kzexal/DATN/type c.webp

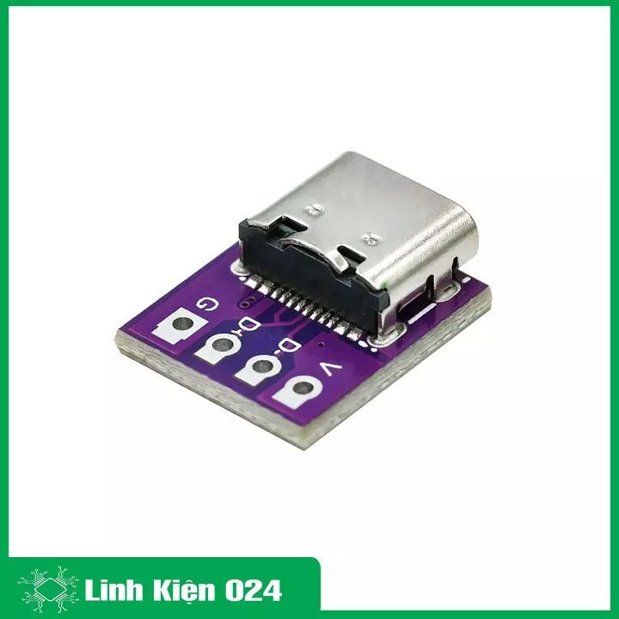
type c.webp
