kzexal/DATN/oled.webp

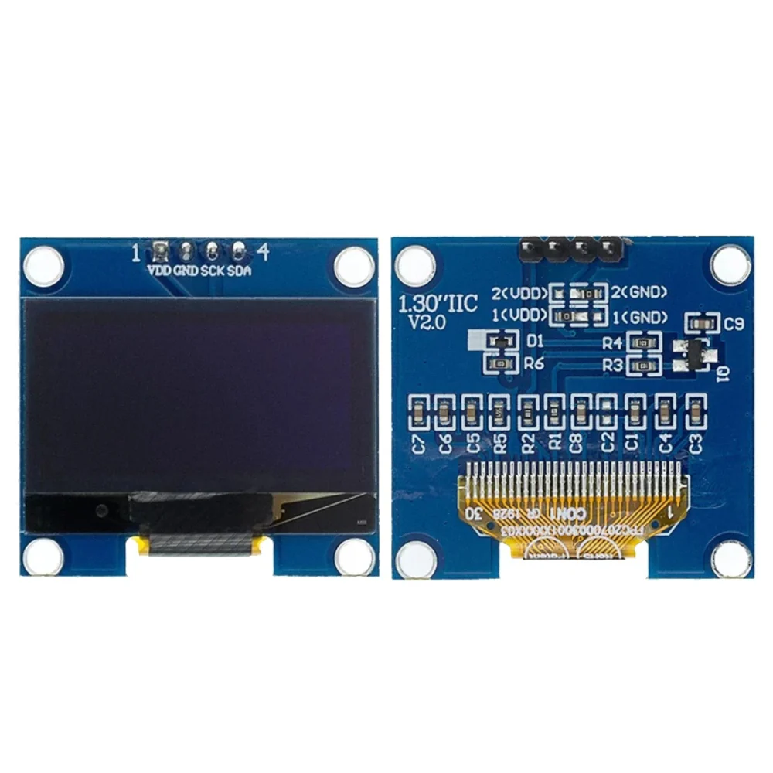
oled.webp
