kzexal/DATN/[SLIDE]_Đào Bá Khánh_ĐATN_Thiết kế, triển khai hệ thống IOT phát hiện và cảnh báo mất trộm, tai nạn xe máy.pptx.pdf

# ĐỒ ÁN TỐT NGHIỆP CỬ NHÂN

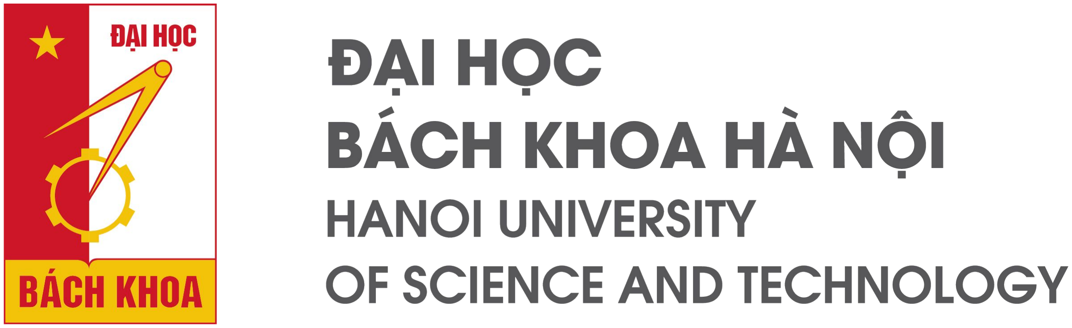
[picture p4: figure]

# THIẾT KẾ, TRIỂN KHAI HỆ THỐNG IOT

PHÁT HIỆN VÀ CẢNH BÁO MẤT TRỘM,

# TAI NẠN XE MÁY

## Đề tài:

Sinh viên: Đào Bá Khánh
MSSV: 20192932 - ET1 09 K64 GVHD: TS. Trịnh Quang Đức

# Demo

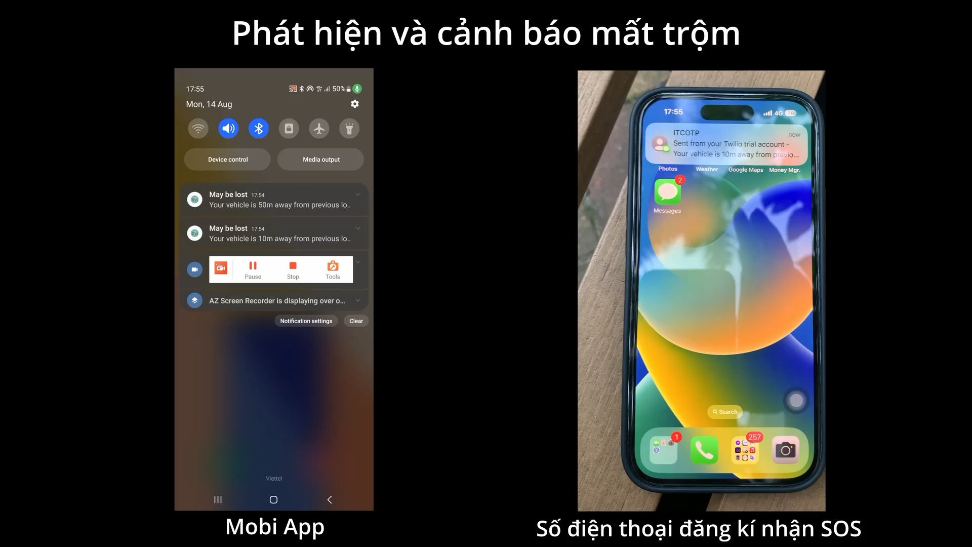
[picture p5: page 4]

## 1. TỔNG QUAN ĐỀ TÀI

5

# NỘI DUNG TRÌNH BÀY

### 1 TỔNG QUAN DỰ ÁN

KIỂM THỬ - ĐÁNH GIÁ

THIẾT KẾ - TRIỂN KHAI HỆ THỐNG

KẾT LUẬN - HƯỚNG PHÁT TRIỂN

2

3

4

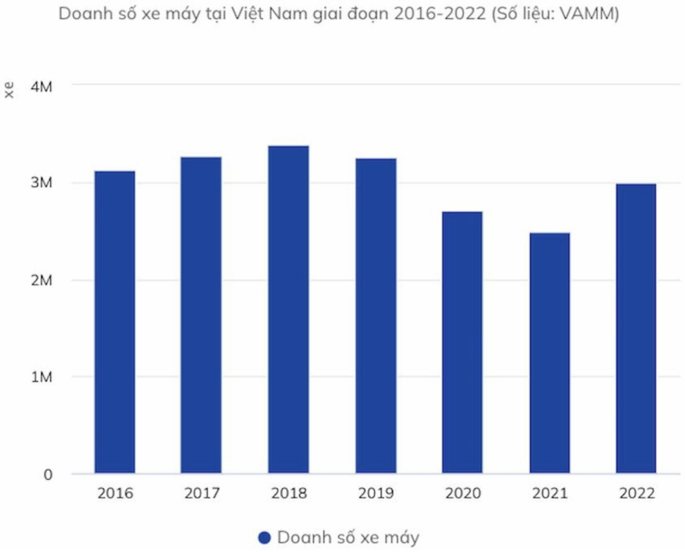
[picture p6: figure]

6

## 1 TỔNG QUAN DỰ ÁN

### 1.1 Đặt vấn đề

Bị mất trộm xe máy

Bị tai nạn liên qua đến xe máy

2022 người Việt mua 3 triệu xe máy

### 8 nghìn xe / ngày

6xe / phút

Vấn đề:

1

## TỔNG QUAN DỰ ÁN

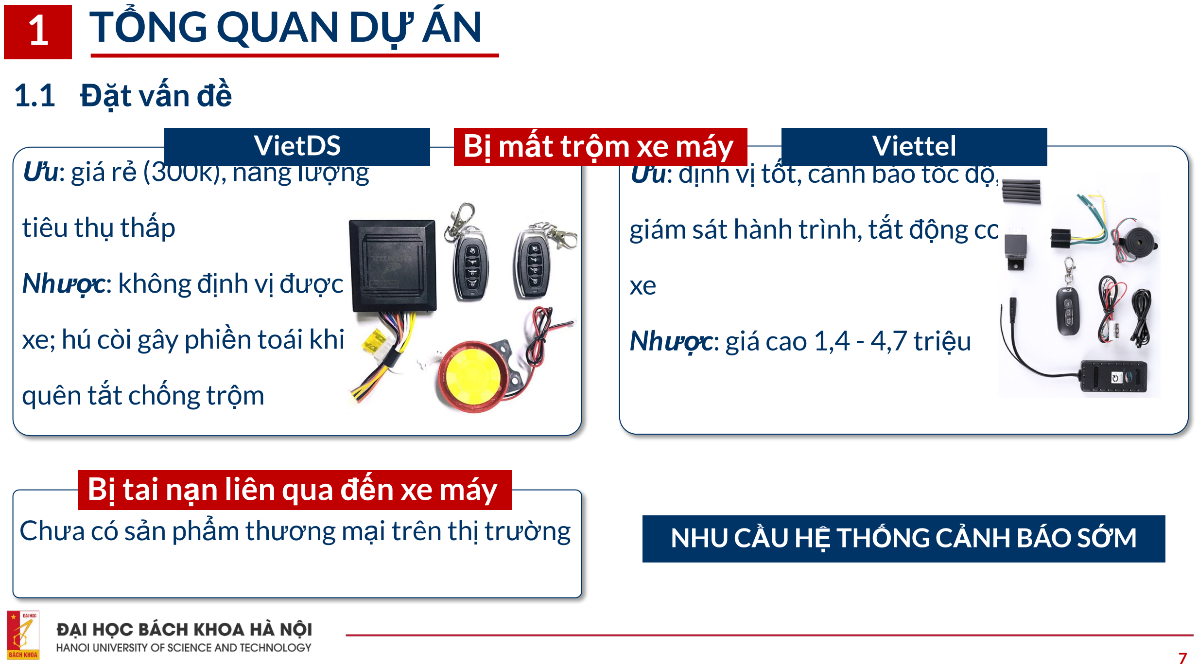
[picture p7: page 7]

7

### 1.1 Đặt vấn đề

NHU CẦU HỆ THỐNG CẢNH BÁO SỚM

Ưu: giá rẻ (300k), năng lượng

tiêu thụ thấp

Nhược: không định vị được

xe; hú còi gây phiền toái khi

quên tắt chống trộm

VietDS
Ưu: định vị tốt, cảnh báo tốc độ,

giám sát hành trình, tắt động cơ

xe

Nhược: giá cao 1,4 - 4,7 triệu

Bị mất trộm xe máy | Viettel

Bị tai nạn liên qua đến xe máy Chưa có sản phẩm thương mại trên thị trường

8

1

### 1.2 Mục tiêu của đồ án tốt nghiệp

- Mất trộm xe máy
- Tai nạn xe máy

Xây dựng hệ thống IOT có khả năng phát hiện và cảnh báo kịp thời:

Giai đoạn của đề tài trong dự án: giai đoạn sơ khai (xây dựng tổng quan hệ thống, xây dựng

nguyên mẫu Device, Mobile App, kiến trúc Backend)

## TỔNG QUAN DỰ ÁN

9

## 2 THIẾT KẾ – TRIỂN KHAI HỆ THỐNG

### 2.1 Yêu cầu chung của hệ thống

- Có khả năng quản lý đồng thời thông tin của nhiều người dùng, phương tiện, thiết bị cảnh

báo

- Thực hiện được việc phát hiện và cảnh báo mất trộm , tai nạn xe máy
- Cơ chế cảnh báo: gọi điện, gửi SMS, ứng dụng điện thoại
- Mỗi thiết bị liên kết với 1 tài khoản. Nhiều người dùng có thể cùng theo dõi 1 thiết bị

## 2 THIẾT KẾ – TRIỂN KHAI HỆ THỐNG

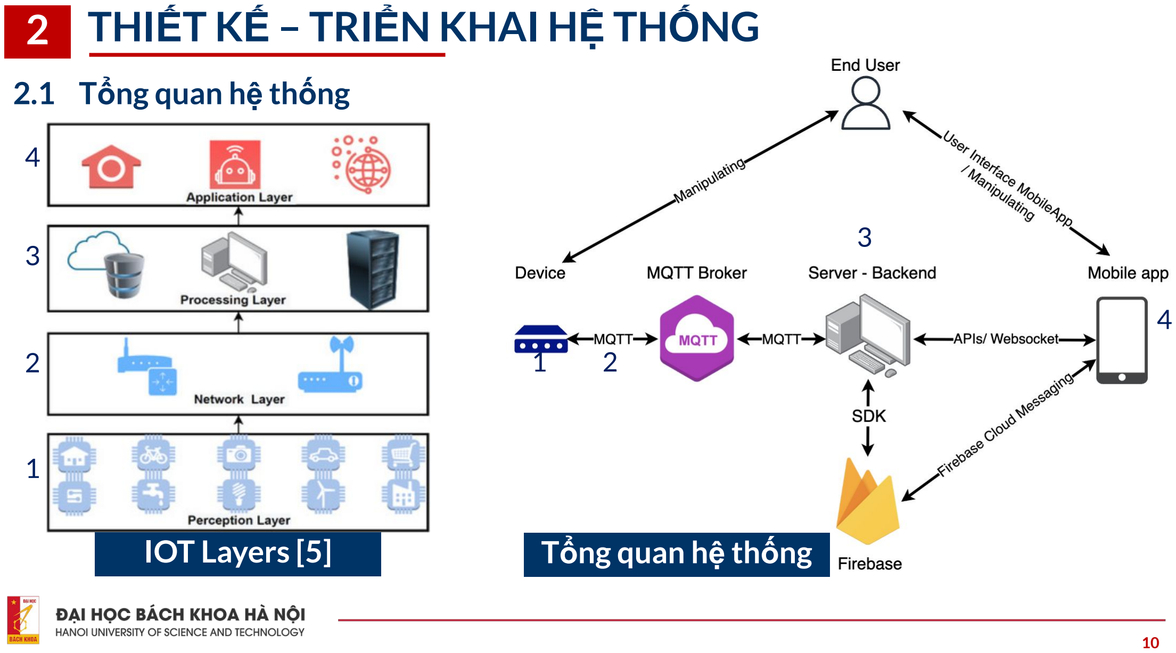
[picture p8: page 10]

10

### 2.1 Tổng quan hệ thống

- Application Layer: Mobile Application | 1
2 | 1 | 2

3

3

4

4

IOT Layers [5] | Tổng quan hệ thống

## 2 THIẾT KẾ – TRIỂN KHAI HỆ THỐNG

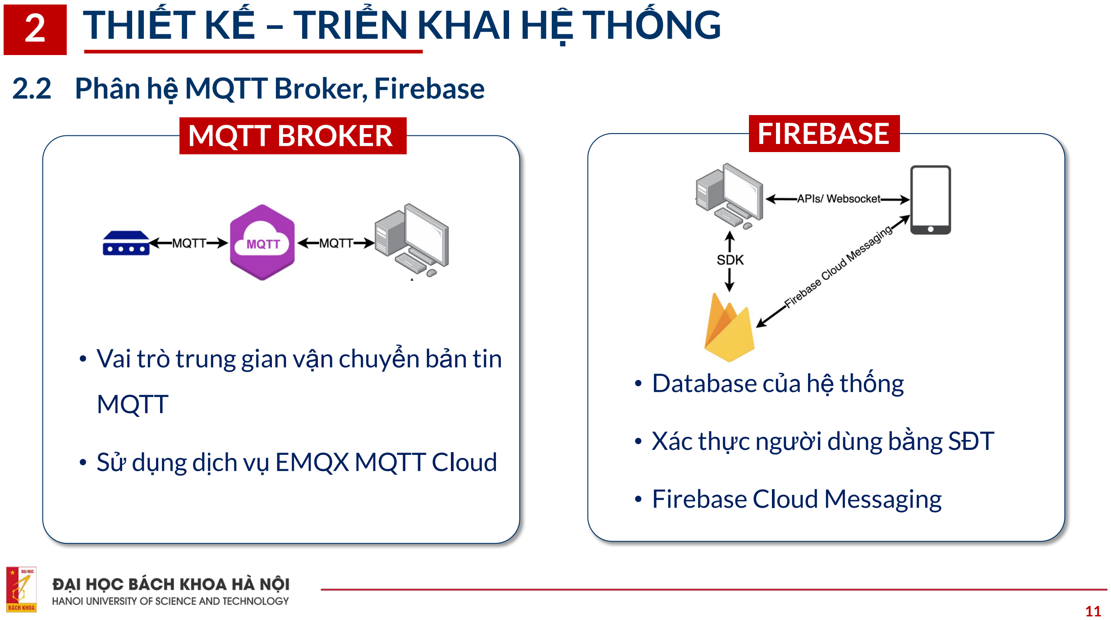
[picture p9: page 11]

11

MQTT BROKER | FIREBASE
- Vai trò trung gian vận chuyển bản tin

MQTT

- Sử dụng dịch vụ EMQX MQTT Cloud
- Database của hệ thống
- Xác thực người dùng bằng SĐT
- Firebase Cloud Messaging

### 2.2 Phân hệ MQTT Broker, Firebase

## 2 THIẾT KẾ – TRIỂN KHAI HỆ THỐNG

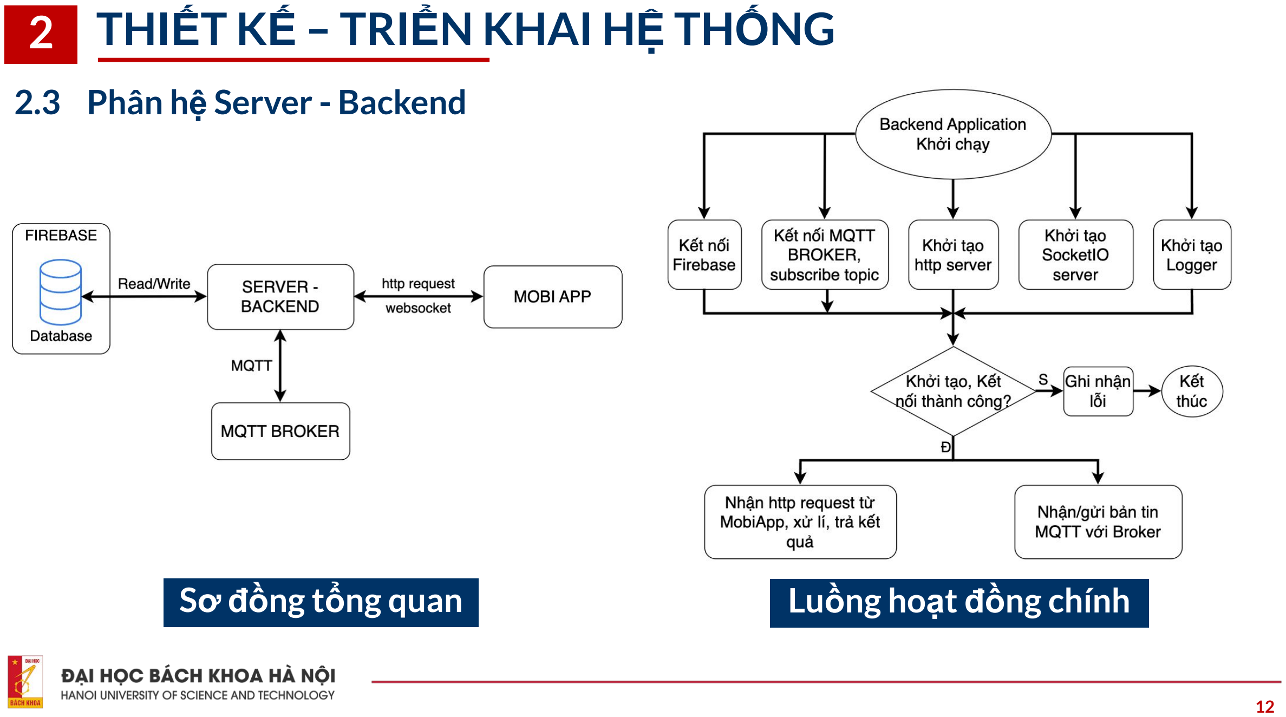
[picture p10: page 12]

12

Sơ đồng tổng quan | Luồng hoạt đồng chính

### 2.3 Phân hệ Server - Backend

## 2 THIẾT KẾ – TRIỂN KHAI HỆ THỐNG

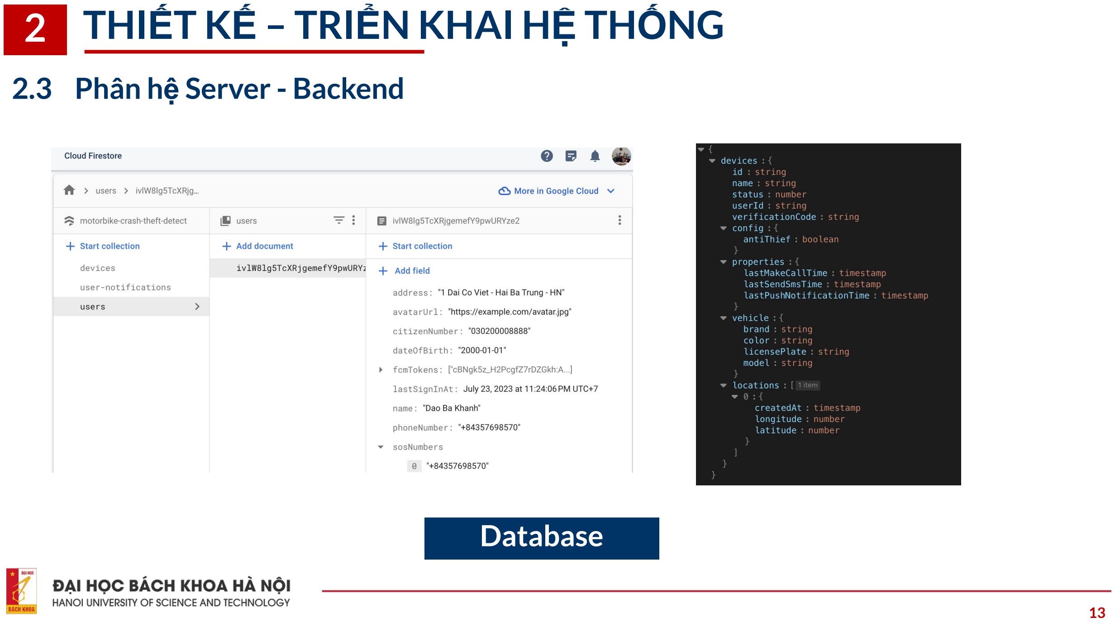
[picture p11: page 13]

13

Database

### 2.3 Phân hệ Server - Backend

## 2 THIẾT KẾ – TRIỂN KHAI HỆ THỐNG

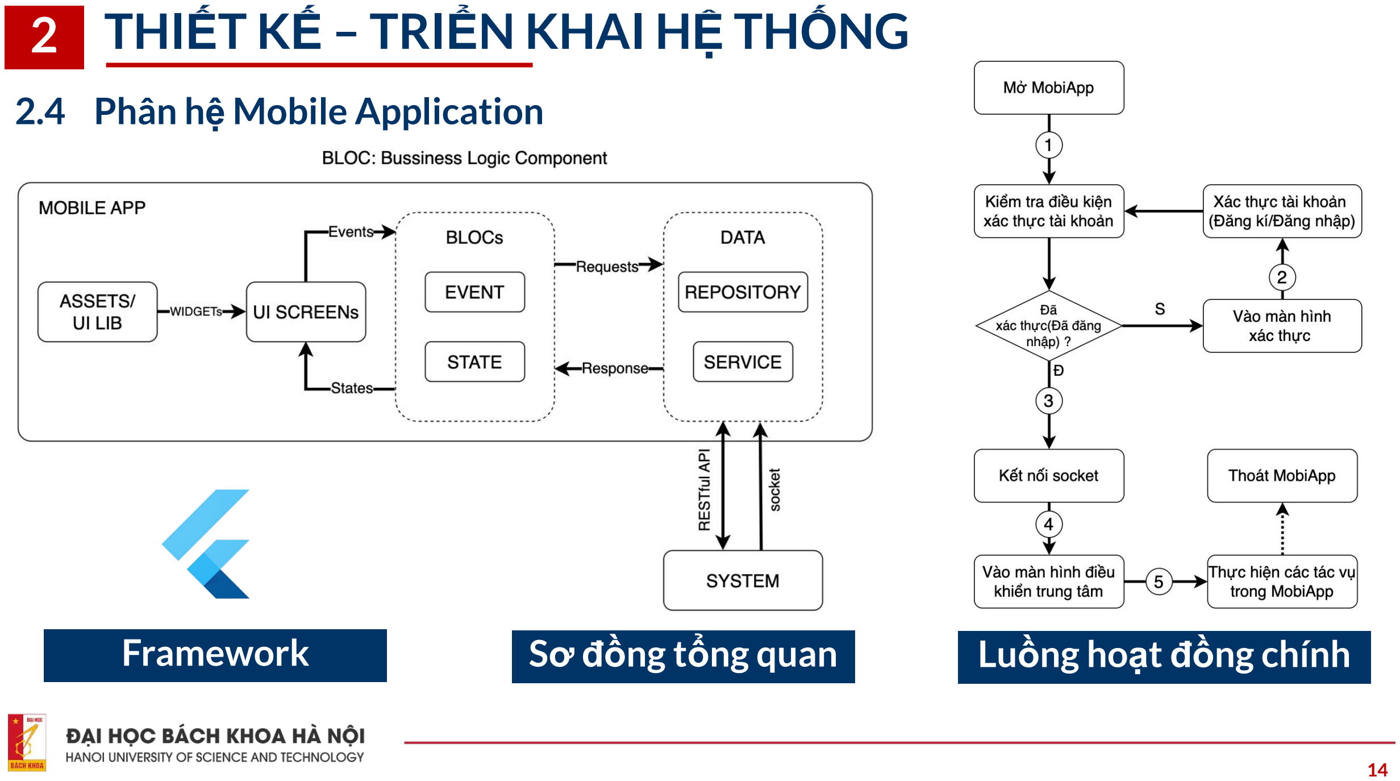
[picture p12: page 14]

14

Framework | Sơ đồng tổng quan | Luồng hoạt đồng chính

### 2.4 Phân hệ Mobile Application

## 2 THIẾT KẾ – TRIỂN KHAI HỆ THỐNG

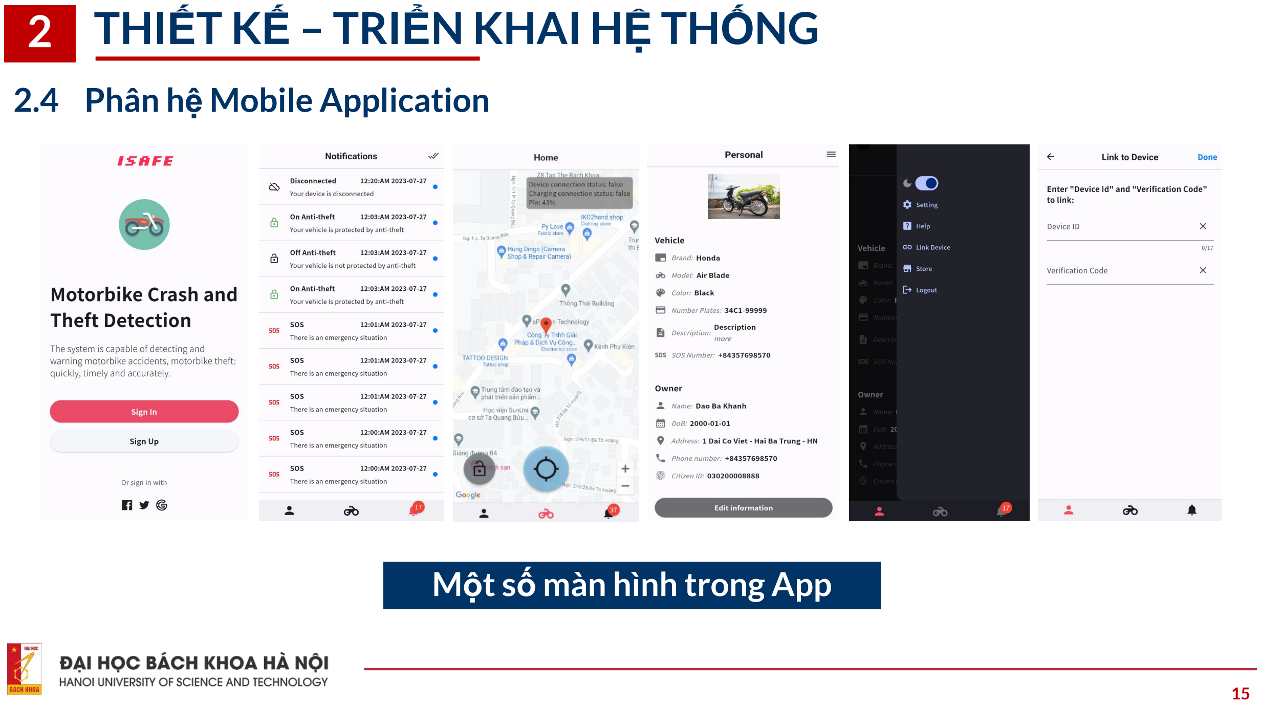
[picture p13: page 15]

15

Một số màn hình trong App

### 2.4 Phân hệ Mobile Application

## 2 THIẾT KẾ – TRIỂN KHAI HỆ THỐNG

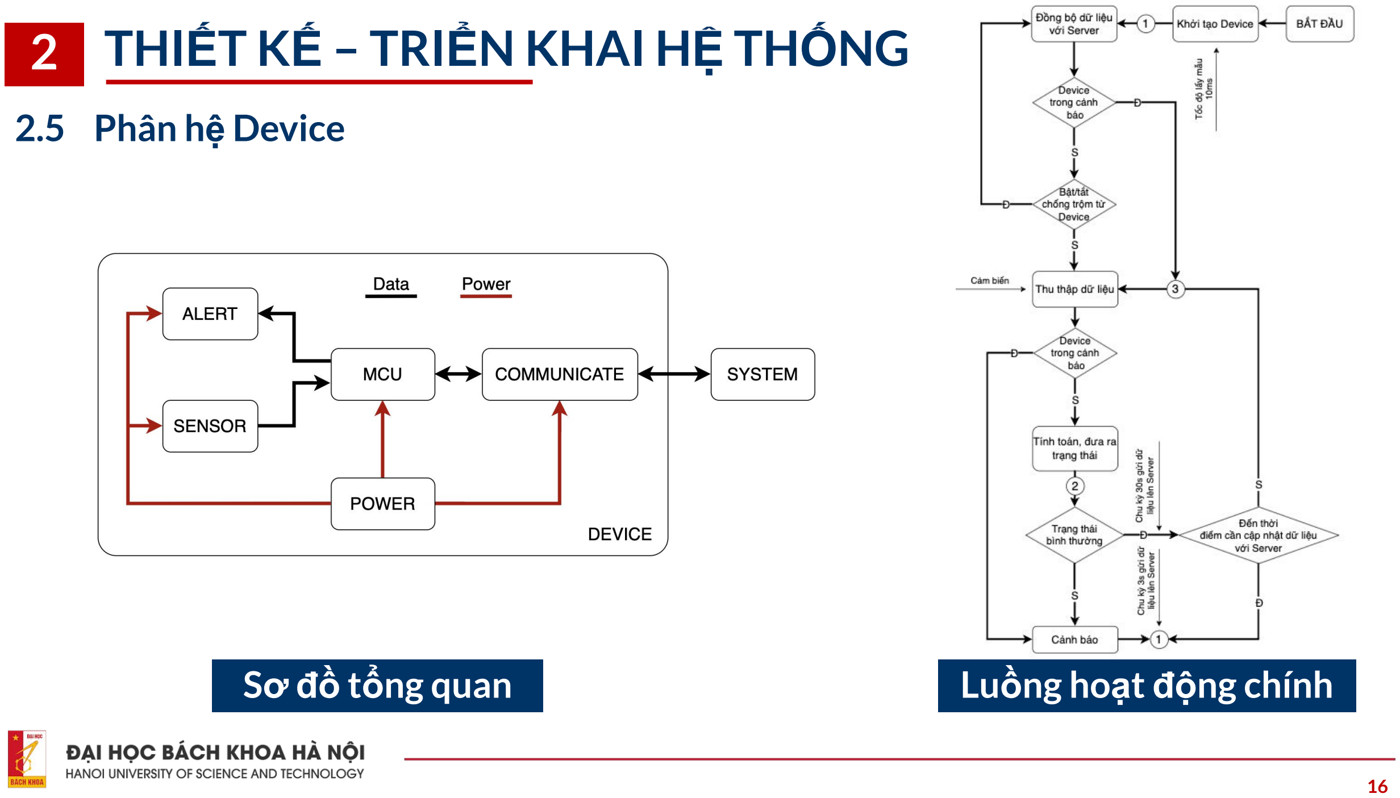
[picture p14: page 16]

16

Sơ đồ tổng quan

### 2.5 Phân hệ Device

Luồng hoạt động chính

## 2 THIẾT KẾ – TRIỂN KHAI HỆ THỐNG

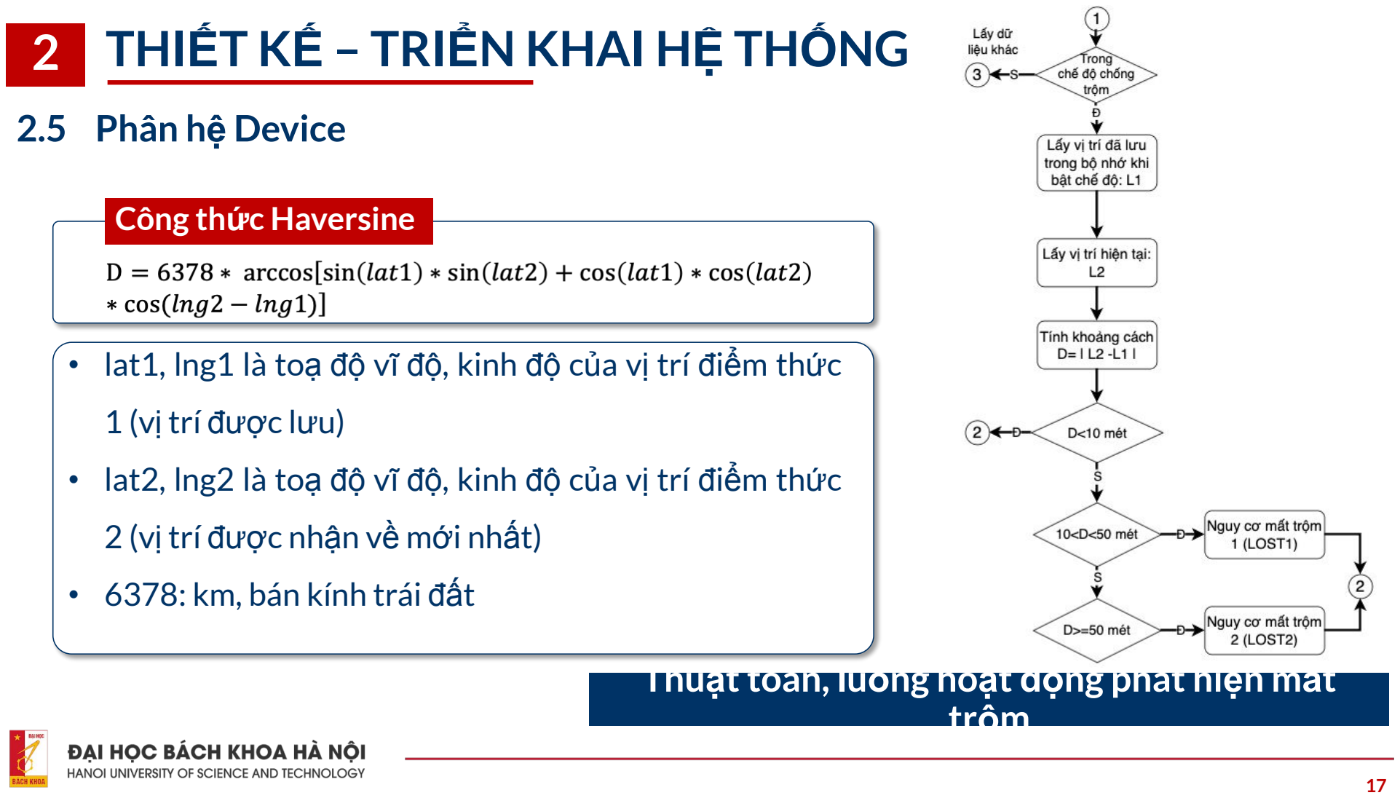
[picture p15: page 17]

17

### 2.5 Phân hệ Device

Thuật toán, luồng hoạt động phát hiện mất trộm

- lat1, lng1 là toạ độ vĩ độ, kinh độ của vị trí điểm thức

1 (vị trí được lưu)
- lat2, lng2 là toạ độ vĩ độ, kinh độ của vị trí điểm thức

2 (vị trí được nhận về mới nhất)

- 6378: km, bán kính trái đất

Công thức Haversine

## 2 THIẾT KẾ – TRIỂN KHAI HỆ THỐNG

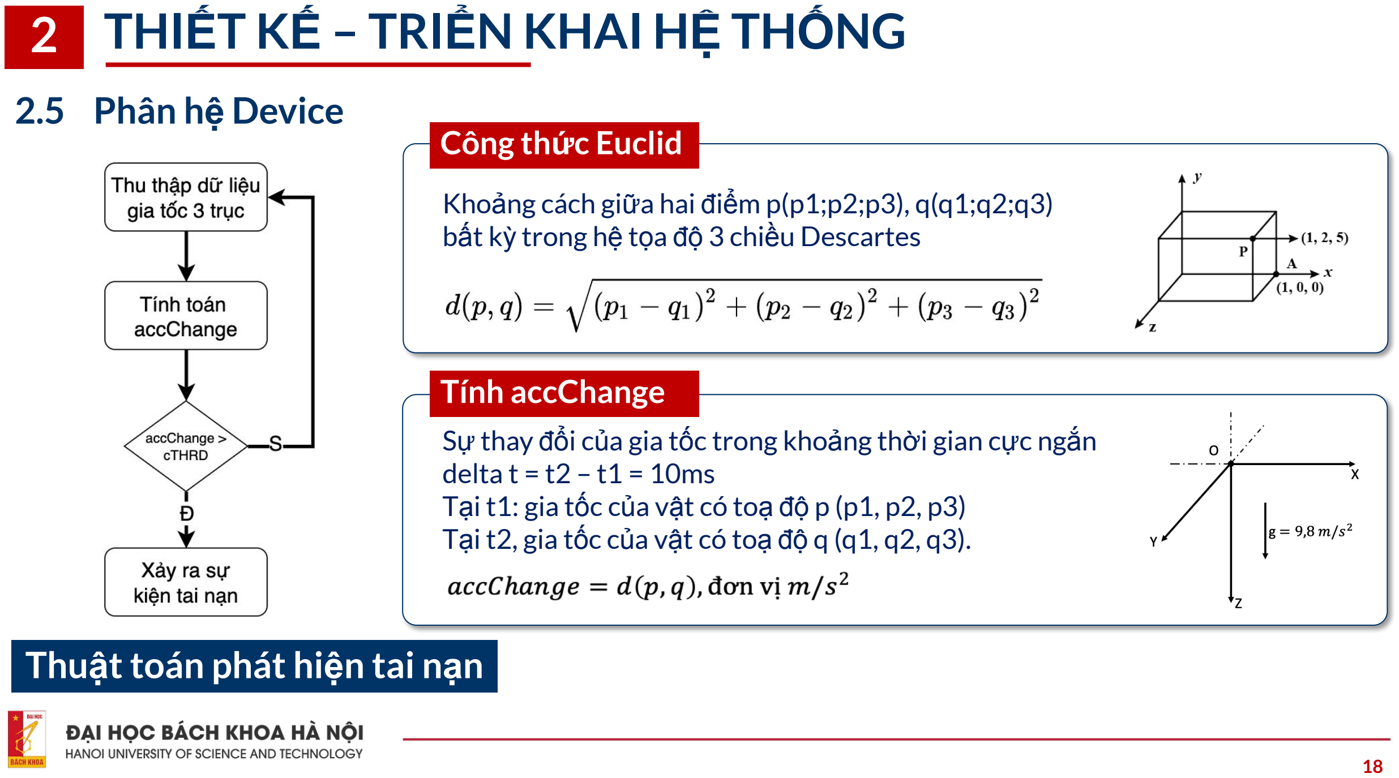
[picture p16: page 18]

18

Thuật toán phát hiện tai nạn

### 2.5 Phân hệ Device

Công thức Euclid

Khoảng cách giữa hai điểm p(p1;p2;p3), q(q1;q2;q3) bất kỳ trong hệ tọa độ 3 chiều Descartes

Tính accChange

Sự thay đổi của gia tốc trong khoảng thời gian cực ngắn delta t = t2 – t1 = 10ms
Tại t1: gia tốc của vật có toạ độ p (p1, p2, p3)
Tại t2, gia tốc của vật có toạ độ q (q1, q2, q3).

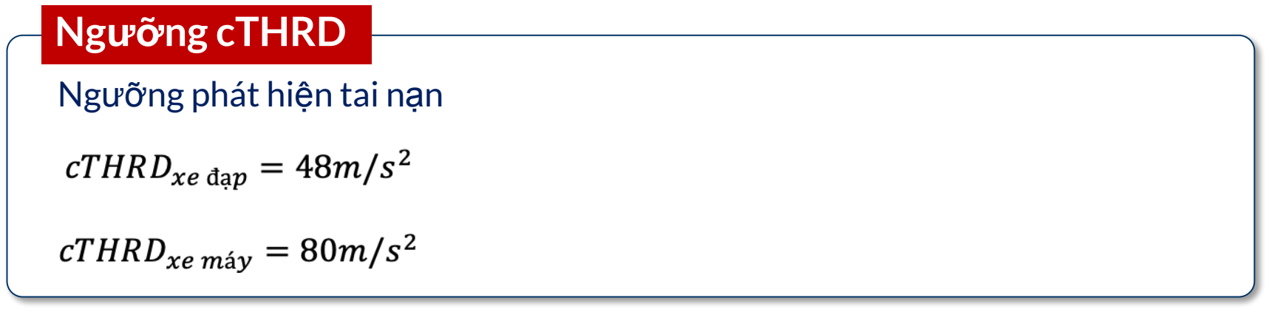
[picture p17: figure]
Ngưỡng cTHRD; Ngưỡng phát hiện tai nạn

19

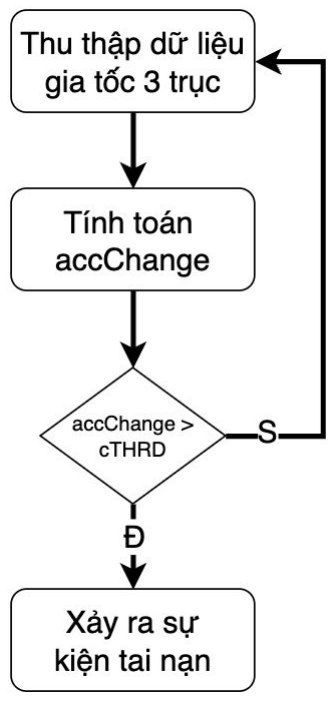
[picture p18: figure]

Thuật toán phát hiện tai nạn

## 2 THIẾT KẾ – TRIỂN KHAI HỆ THỐNG

### 2.5 Phân hệ Device

## 2 THIẾT KẾ – TRIỂN KHAI HỆ THỐNG

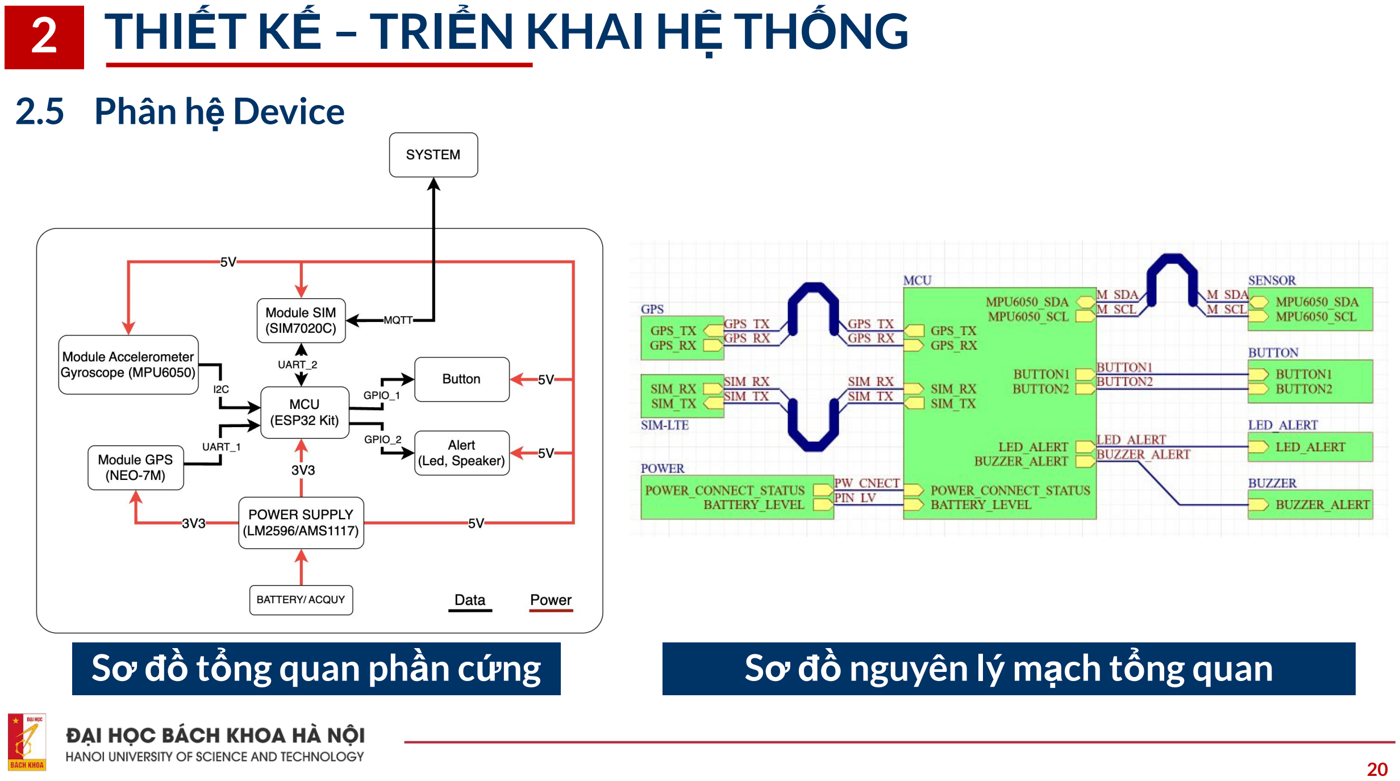
[picture p19: page 20]

20

Sơ đồ tổng quan phần cứng

### 2.5 Phân hệ Device

Sơ đồ nguyên lý mạch tổng quan

## 2 THIẾT KẾ – TRIỂN KHAI HỆ THỐNG

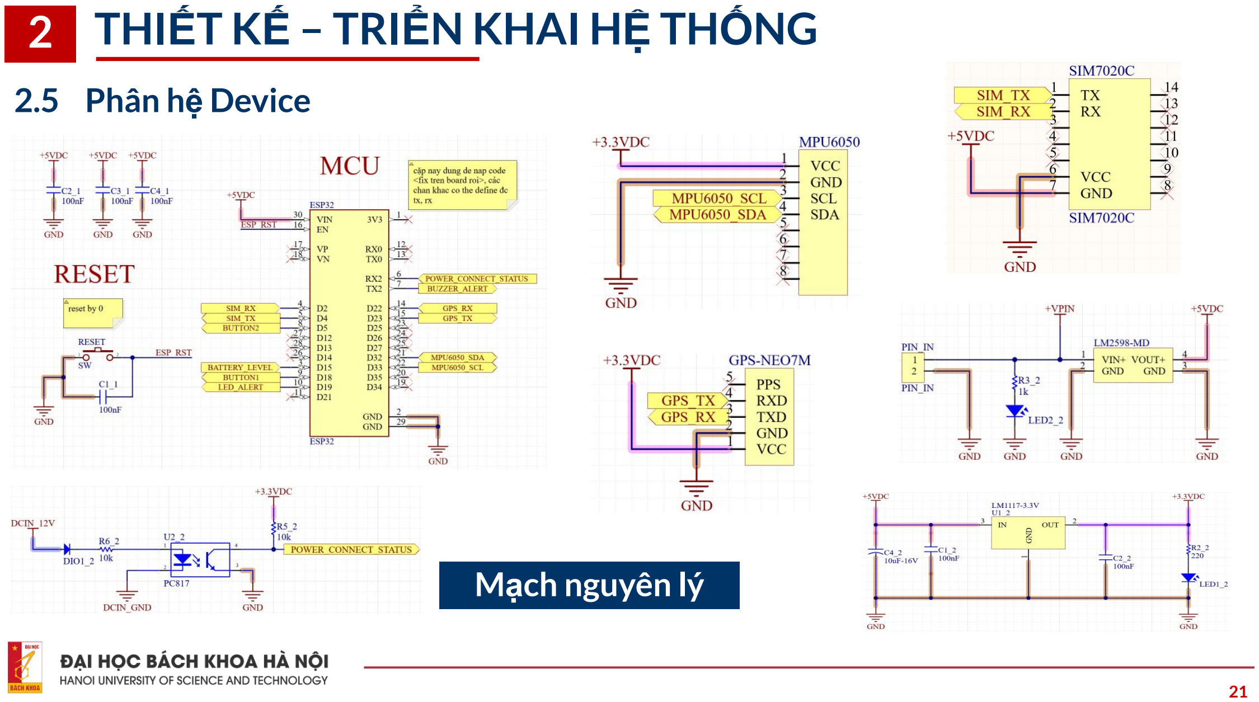
[picture p20: page 21]

21

Mạch nguyên lý

### 2.5 Phân hệ Device

## 2 THIẾT KẾ – TRIỂN KHAI HỆ THỐNG

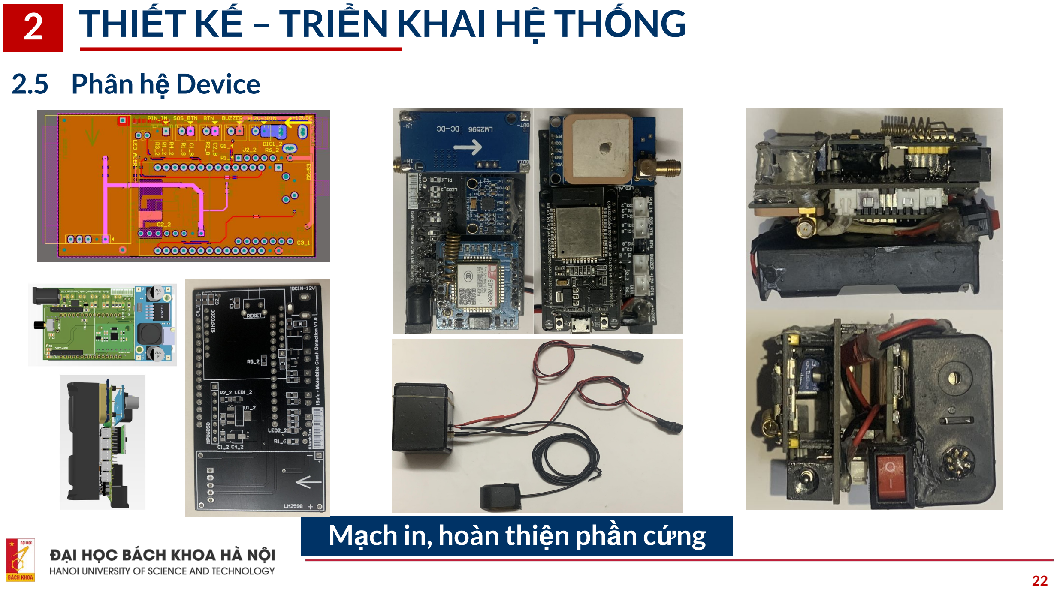
[picture p21: page 22]

22

Mạch in, hoàn thiện phần cứng

### 2.5 Phân hệ Device

## 3 KIỂM THỬ- ĐÁNH GIÁ

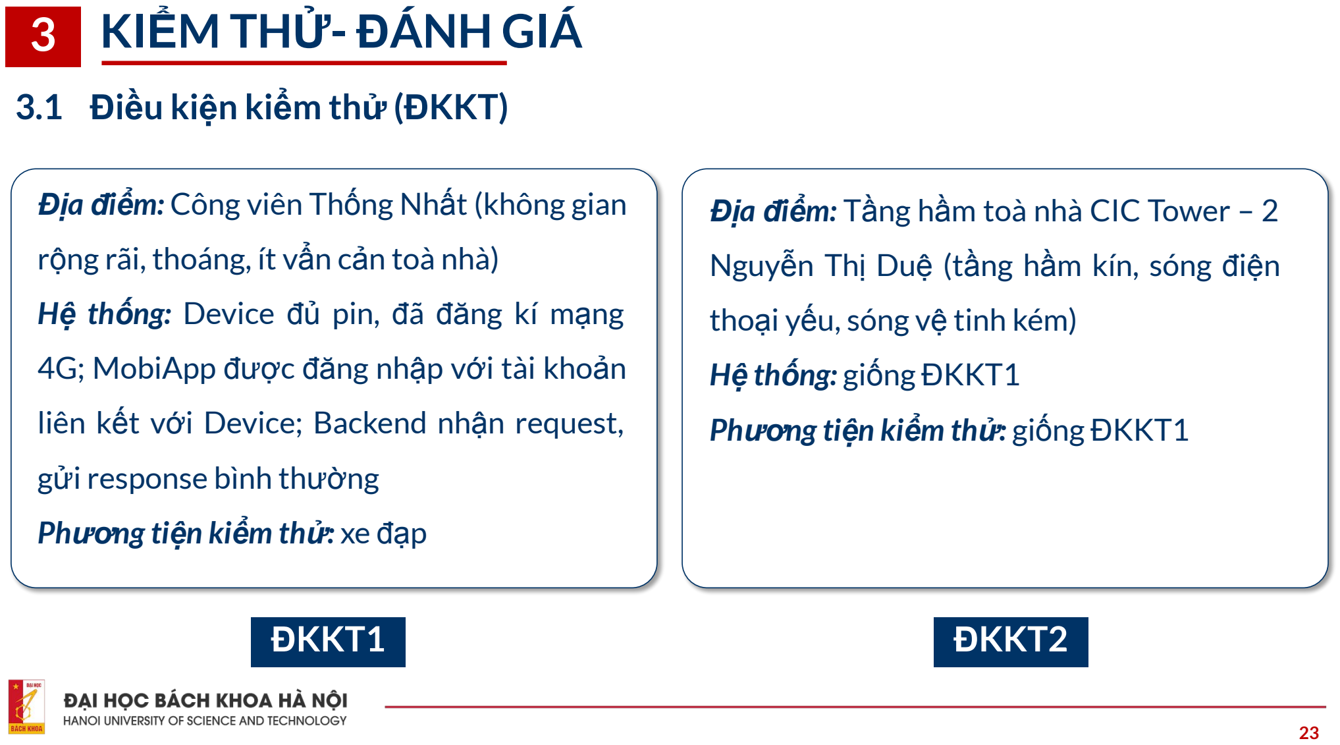
[picture p22: page 23]

23

ĐKKT1

### 3.1 Điều kiện kiểm thử (ĐKKT)

Địa điểm: Công viên Thống Nhất (không gian

rộng rãi, thoáng, ít vẩn cản toà nhà)

Hệ thống: Device đủ pin, đã đăng kí mạng

4G; MobiApp được đăng nhập với tài khoản liên kết với Device; Backend nhận request,

gửi response bình thường
Phương tiện kiểm thử: xe đạp

Địa điểm: Tầng hầm toà nhà CIC Tower – 2

Nguyễn Thị Duệ (tầng hầm kín, sóng điện

thoại yếu, sóng vệ tinh kém)

Hệ thống: giống ĐKKT1

Phương tiện kiểm thử: giống ĐKKT1

ĐKKT2

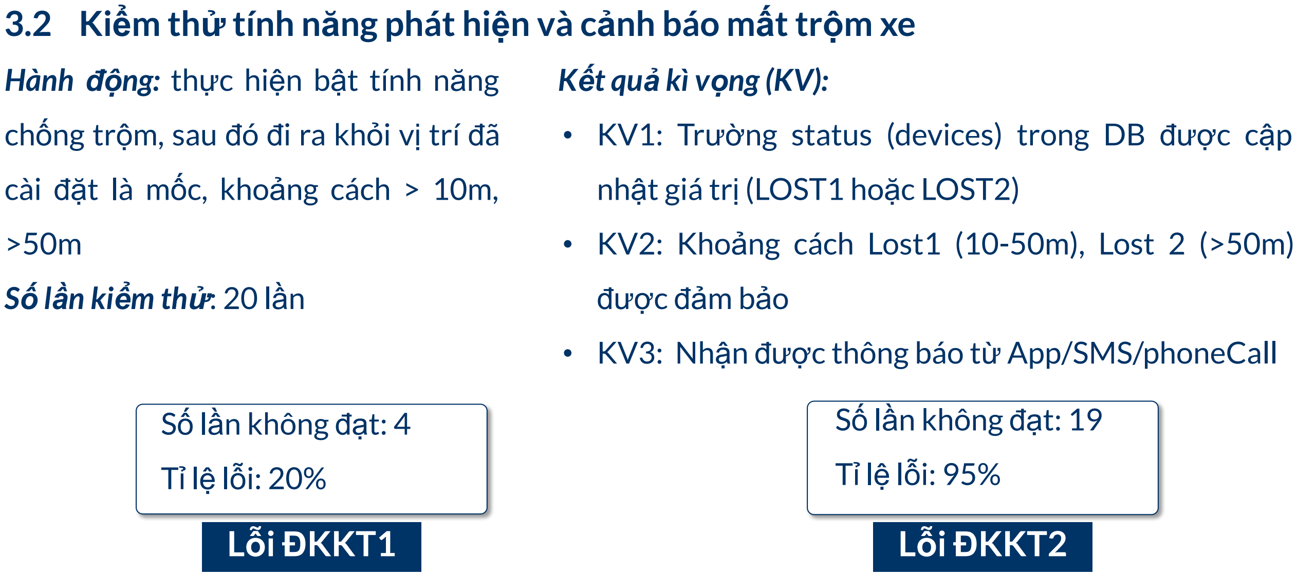
[picture p23: figure]
Hành động: thực hiện bật tính năng; chống trộm, sau đó đi ra khỏi vị trí đã; cài đặt là mốc, khoảng cách > 10m,; Số lần kiểm thử: 20 lần; Lỗi ĐKKT1; Số lần không đạt: 4; Tỉ lệ lỗi: 20%; Số lần không đạt: 19; Tỉ lệ lỗi: 95%; Lỗi ĐKKT2; Kết quả kì vọng (KV):; nhật giá trị (LOST1 hoặc LOST2); được đảm bảo

24

## 3 KIỂM THỬ- ĐÁNH GIÁ

### 3.2 Kiểm thử tính năng phát hiện và cảnh báo mất trộm xe

- KV1: Trường status (devices) trong DB được cập
- KV2: Khoảng cách Lost1 (10-50m), Lost 2 (>50m)
- KV3: Nhận được thông báo từ App/SMS/phoneCall

25

## 3 KIỂM THỬ- ĐÁNH GIÁ

### 3.3 Kiểm thử tính năng phát hiện và cảnh báo tai nạn xe

Hành động: mô phỏng tình huống

bằng cách đâm xe đạp vào tường

Số lần kiểm thử: 20 lần

Kết quả kì vọng (KV):

- KV1: Trường status (devices) trong DB được cập

nhật giá trị (CRASH) 2
- KV2: Còi Device kêu liên tục tiếng “bíp”
- KV3: Nhận được thông báo từ App/SMS/phoneCall

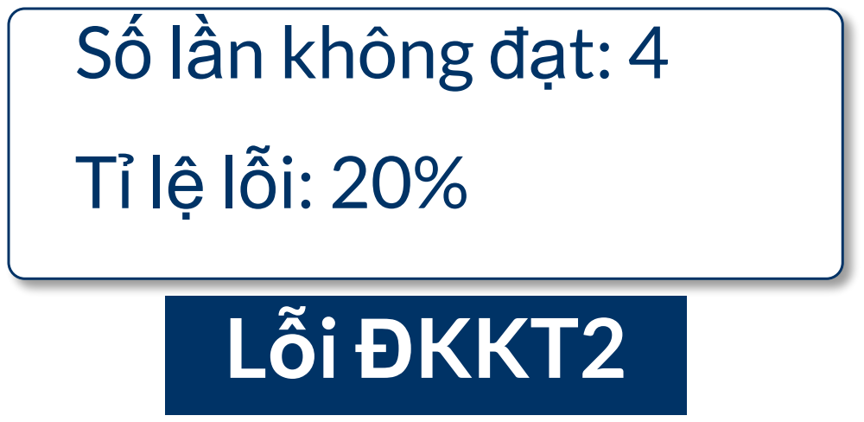
[picture p24: figure]
Số lần không đạt: 4; Tỉ lệ lỗi: 20%; Lỗi ĐKKT2
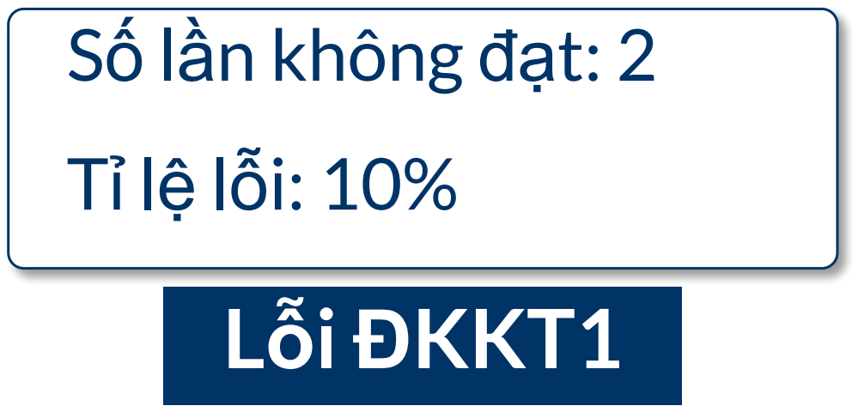
[picture p25: figure]
Lỗi ĐKKT1; Số lần không đạt: 2; Tỉ lệ lỗi: 10%

26

## 3 KIỂM THỬ- ĐÁNH GIÁ

### 3.4 Đánh giá

- Kết quả thử nghiệm thể hiện được tỉ lệ lỗi trên 20 lần đo
- Tỉ lệ lỗi ĐKKT1 từ 10-20%, có thể là do mất bản tin trên đường truyền.
- Lỗi chung xuất hiện tại ĐKKT2 cao hơn ĐKKT1
- Môi trường ĐKKT2 sóng điện thoại yếu, dẫn tới tình trạng không thể gửi / gửi lỗi bản tin

MQTT

- Tỉ lệ lỗi liên quan tới xác định vị trí bằng GPS, xảy ra gần như tuyệt đối (95%) với ĐKKT2
- Môi trường ĐKKT2 có sóng GPS kém, không thể lấy vị trí chính xác.

## 4 KẾT LUẬN – HƯỚNG PHÁT TRIỂN

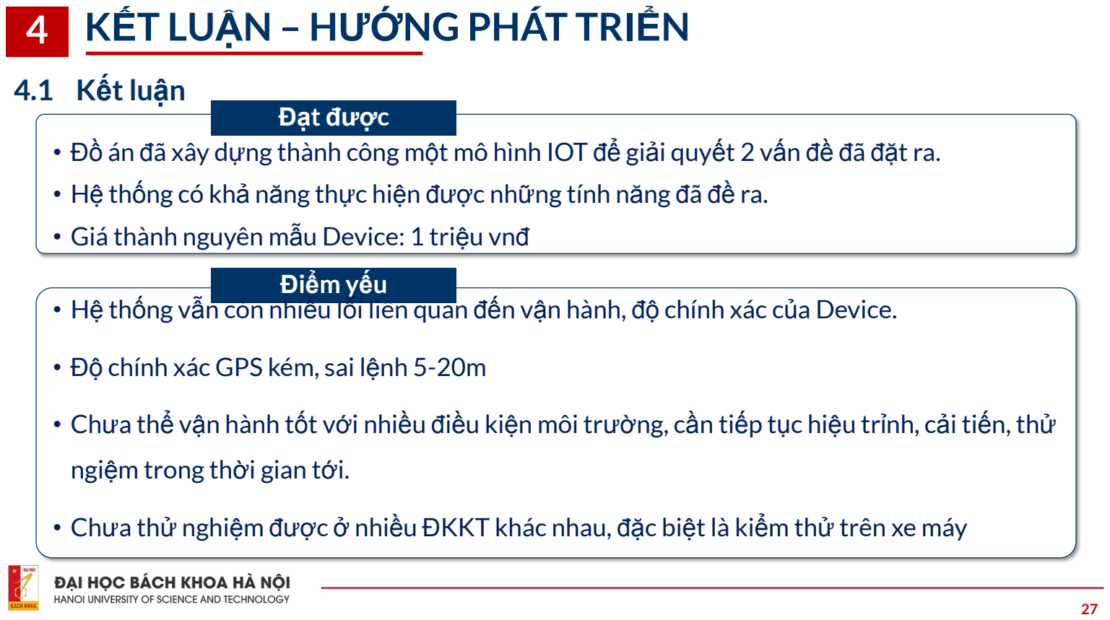
[picture p26: page 27]

27

### 4.1 Kết luận

Đạt được
- Đồ án đã xây dựng thành công một mô hình IOT để giải quyết 2 vấn đề đã đặt ra.
- Hệ thống có khả năng thực hiện được những tính năng đã đề ra.
- Giá thành nguyên mẫu Device: 1 triệu vnđ

Điểm yếu
- Hệ thống vẫn còn nhiều lỗi liên quan đến vận hành, độ chính xác của Device.
- Độ chính xác GPS kém, sai lệnh 5-20m
- Chưa thể vận hành tốt với nhiều điều kiện môi trường, cần tiếp tục hiệu trỉnh, cải tiến, thử

ngiệm trong thời gian tới.

- Chưa thử nghiệm được ở nhiều ĐKKT khác nhau, đặc biệt là kiểm thử trên xe máy

## 4 KẾT LUẬN – HƯỚNG PHÁT TRIỂN

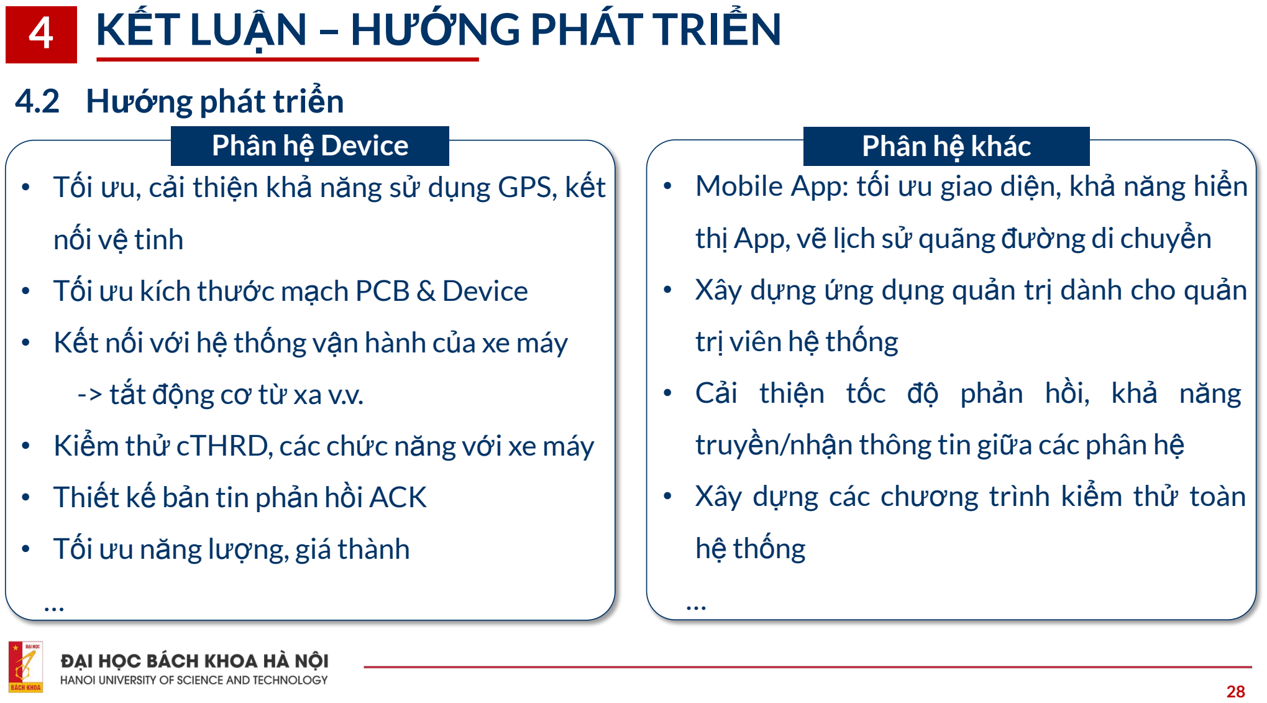
[picture p27: page 28]

28

### 4.2 Hướng phát triển

- Tối ưu, cải thiện khả năng sử dụng GPS, kết

nối vệ tinh

- Tối ưu kích thước mạch PCB & Device
- Kết nối với hệ thống vận hành của xe máy

-> tắt động cơ từ xa v.v.

- Kiểm thử cTHRD, các chức năng với xe máy
- Thiết kế bản tin phản hồi ACK
- Tối ưu năng lượng, giá thành

…

- Mobile App: tối ưu giao diện, khả năng hiển

thị App, vẽ lịch sử quãng đường di chuyển

- Xây dựng ứng dụng quản trị dành cho quản trị viên hệ thống
- Cải thiện tốc độ phản hồi, khả năng

truyền/nhận thông tin giữa các phân hệ

- Xây dựng các chương trình kiểm thử toàn

hệ thống

…

Phân hệ Device | Phân hệ khác

29

## TÀI LIỆU THAM KHẢO

1. Báo cáo VAMM (Hiệp hội các nhà sản xuất xe máy Việt Nam)

quý IV/2022
2. Báo cáo của Tổ chức Y tế Thế giới WHO
3. Báo cáo Công An TP Hà Nội, TP. Hồ Chí Minh
4. Nguồn ảnh: VietDS, Viettel
5. H. M. Alshahrani, "CoLL-IoT: A Collaborative Intruder Detection

System for Internet of Things Devices,"

# THANK YOU !

30

# SLIDE BỔ TRỢ

31

1

## TỔNG QUAN DỰ ÁN (SLIDE BỔ TRỢ)

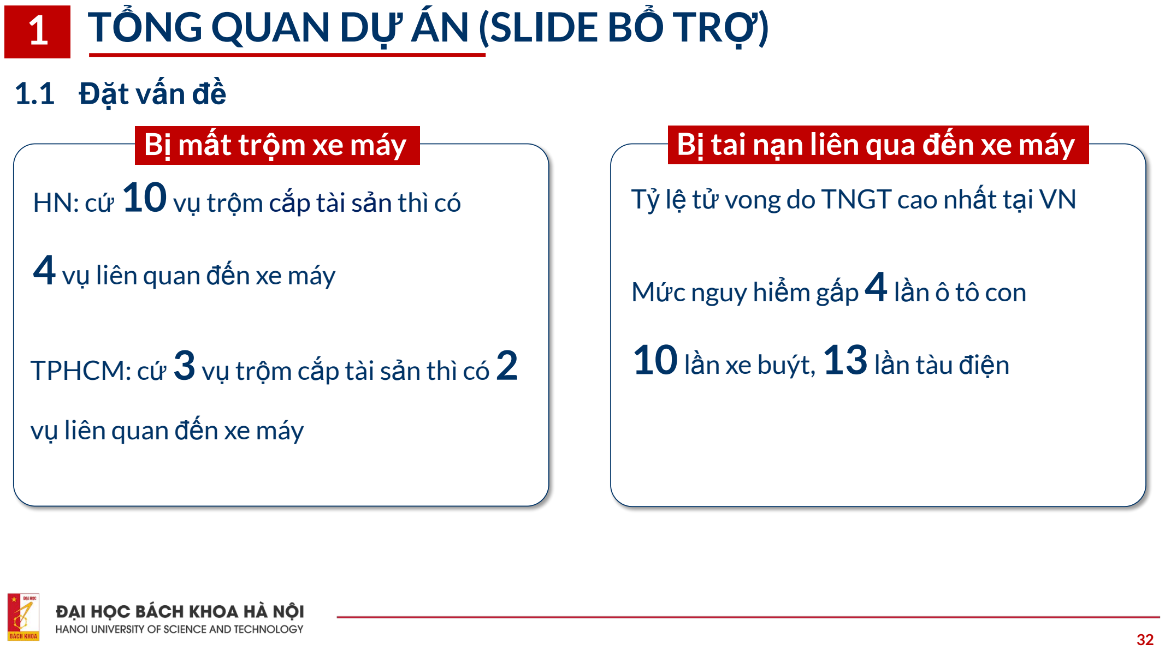
[picture p28: page 32]

32

### 1.1 Đặt vấn đề

Bị mất trộm xe máy | Bị tai nạn liên qua đến xe máy

HN: cứ 10vụ trộm cắp tài sản thì có

4vụ liên quan đến xe máy

TPHCM: cứ 3vụ trộm cắp tài sản thì có 2

vụ liên quan đến xe máy

Mức nguy hiểm gấp 4lần ô tô con

10lần xe buýt, 13lần tàu điện

Tỷ lệ tử vong do TNGT cao nhất tại VN

33

1

### 1.3 Đối tượng khách hàng của dự án

- Người dùng xe máy
- Đơn vị cung cấp dịch vụ thuê xe máy
- Đơn vị sử dụng xe máy để vận chuyển hàng/người

## TỔNG QUAN DỰ ÁN (SLIDE BỔ TRỢ)

34

## 1 TỔNG QUAN DỰ ÁN (SLIDE BỔ TRỢ)

### 1.4 Phương pháp thực hiện

1. Nghiên cứu và phân tích
2. Thiết kế hệ thống
3. Xây dựng phân hệ phần cứng
4. Xây dựng phân hệ phần mềm
5. Kiểm thử và đánh giá hiệu quả
6. Đưa ra hướng tối ưu, cải tiến

35

## 1 TỔNG QUAN DỰ ÁN (SLIDE BỔ TRỢ)

### 1.5 Các tiêu chí đánh giá hệ thống

1. Độ chính xác
2. Tính khả dụng
3. Tính tin cậy, bảo mật
4. Hiệu xuất
5. Tính linh hoạt
6. Dễ dàng sử dụng
7. Chi phí
8. Hiệu quả

## 2 THIẾT KẾ – TRIỂN KHAI HỆ THỐNG (SLIDE BỔ TRỢ)

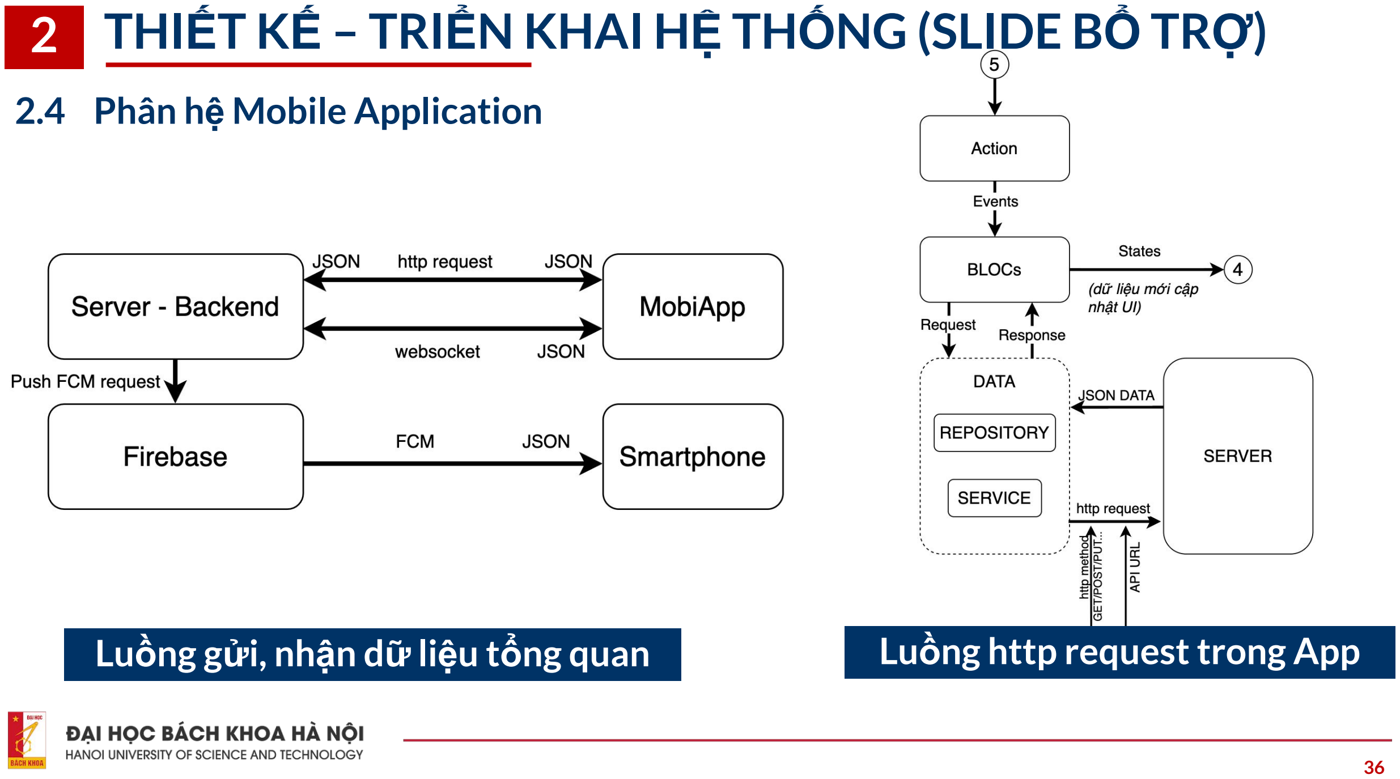
[picture p29: page 36]

36

Luồng gửi, nhận dữ liệu tổng quan | Luồng http request trong App

### 2.4 Phân hệ Mobile Application

## 2 THIẾT KẾ – TRIỂN KHAI HỆ THỐNG (SLIDE BỔ TRỢ)

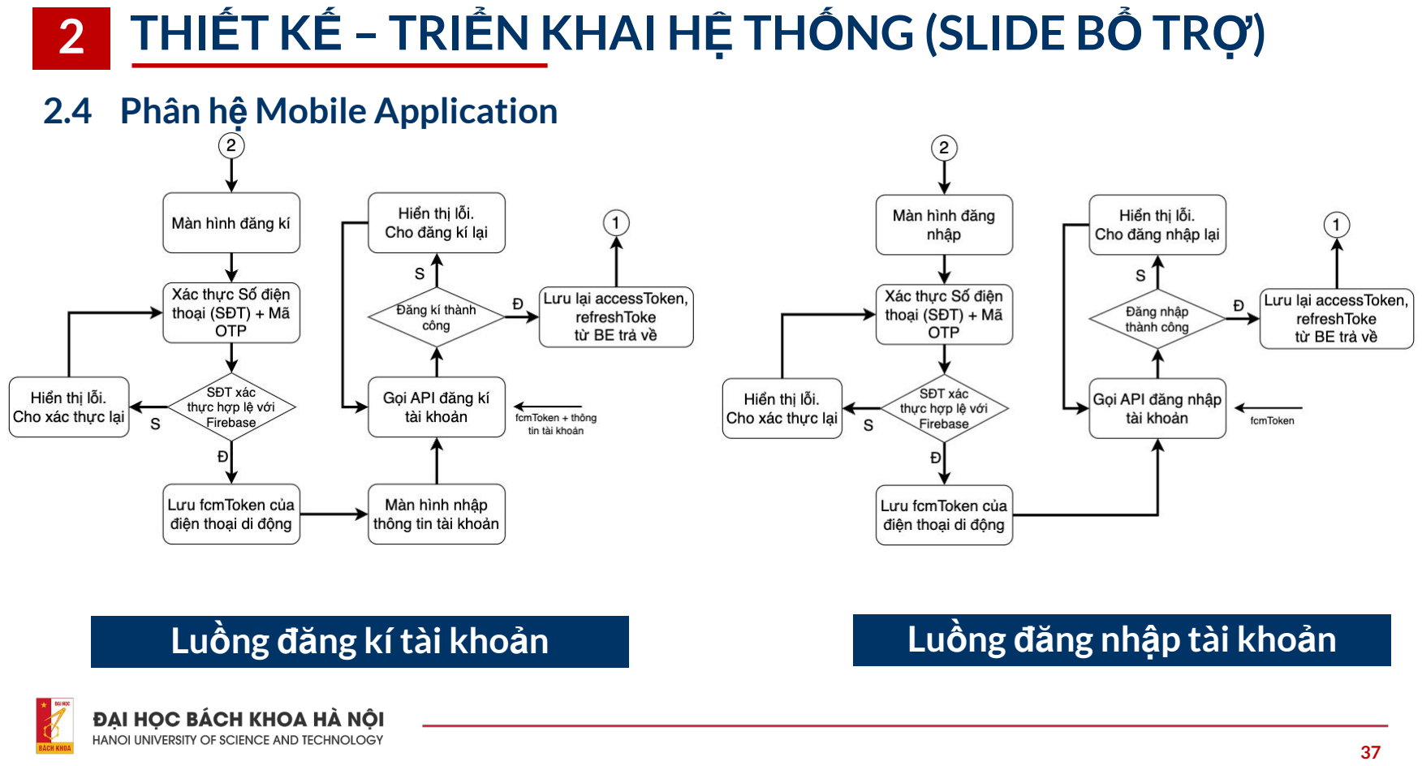
[picture p30: page 37]

37

Luồng đăng kí tài khoản | Luồng đăng nhập tài khoản

### 2.4 Phân hệ Mobile Application

38

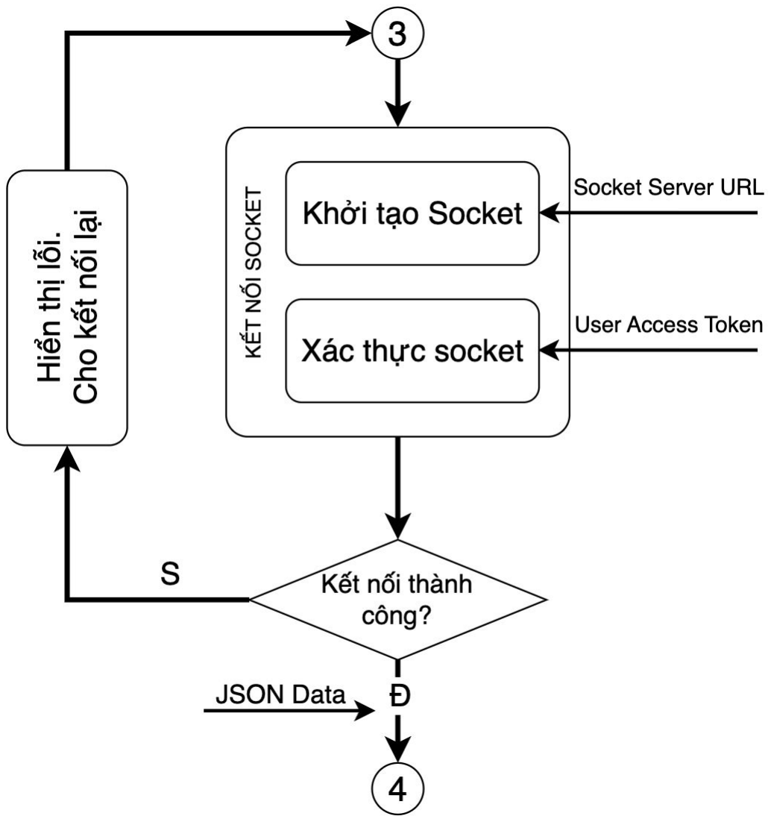
[picture p31: figure]

Luồng kết nối máy chủ socket

## 2 THIẾT KẾ – TRIỂN KHAI HỆ THỐNG (SLIDE BỔ TRỢ)

### 2.4 Phân hệ Mobile Application

## 2 THIẾT KẾ – TRIỂN KHAI HỆ THỐNG (SLIDE BỔ TRỢ)

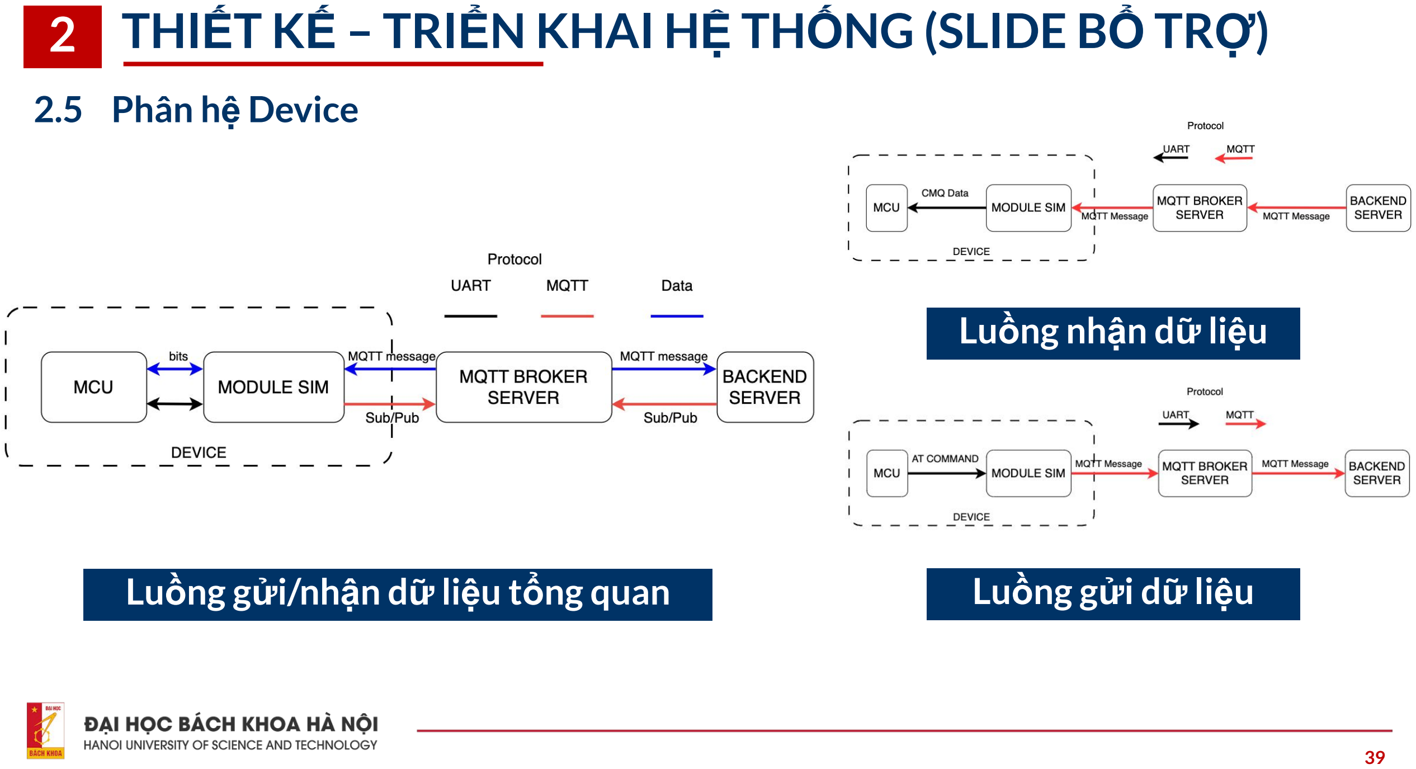
[picture p32: page 39]

39

Luồng gửi/nhận dữ liệu tổng quan

### 2.5 Phân hệ Device

Luồng nhận dữ liệu

Luồng gửi dữ liệu

## 2 THIẾT KẾ – TRIỂN KHAI HỆ THỐNG (SLIDE BỔ TRỢ)

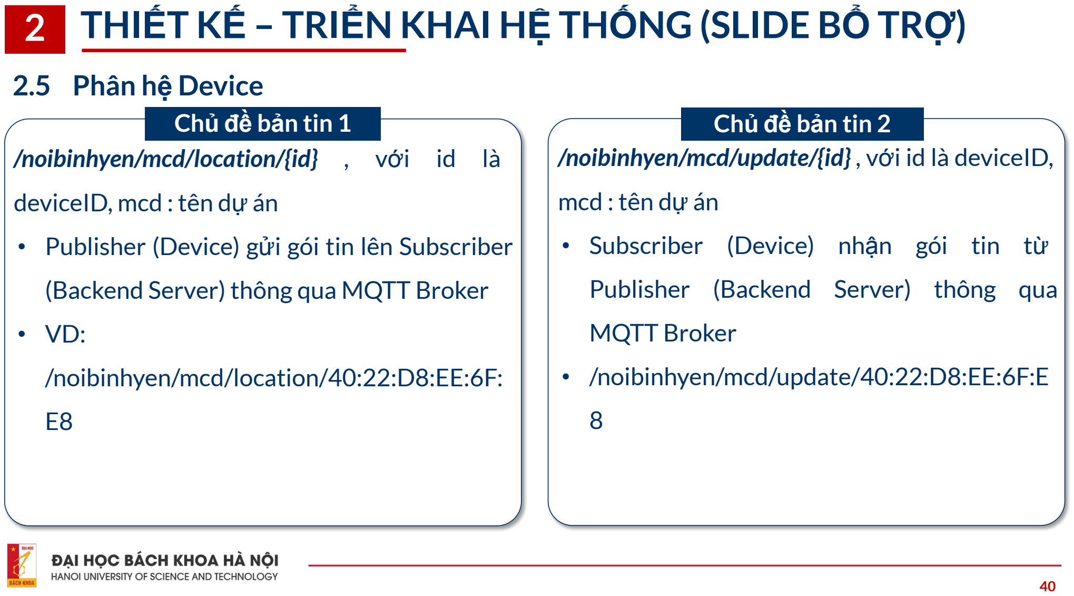
[picture p33: page 40]

40

### 2.5 Phân hệ Device

/noibinhyen/mcd/location/{id} , với id là

deviceID, mcd : tên dự án

- Publisher (Device) gửi gói tin lên Subscriber

(Backend Server) thông qua MQTT Broker

- VD:

/noibinhyen/mcd/location/40:22:D8:EE:6F:

E8

/noibinhyen/mcd/update/{id} , với id là deviceID,

mcd : tên dự án

- Subscriber (Device) nhận gói tin từ

Publisher (Backend Server) thông qua

MQTT Broker

- /noibinhyen/mcd/update/40:22:D8:EE:6F:E

8

Chủ đề bản tin 1 | Chủ đề bản tin 2

## 2 THIẾT KẾ – TRIỂN KHAI HỆ THỐNG (SLIDE BỔ TRỢ)

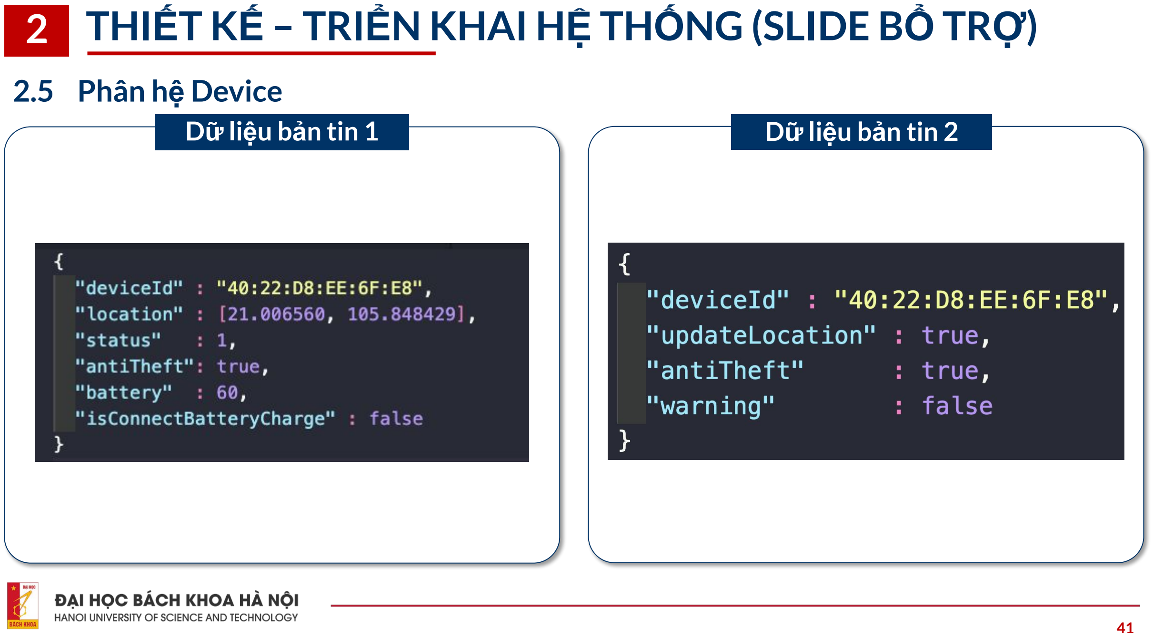
[picture p34: page 41]

41

### 2.5 Phân hệ Device

Dữ liệu bản tin 1 | Dữ liệu bản tin 2

## 2 THIẾT KẾ – TRIỂN KHAI HỆ THỐNG (SLIDE BỔ TRỢ)

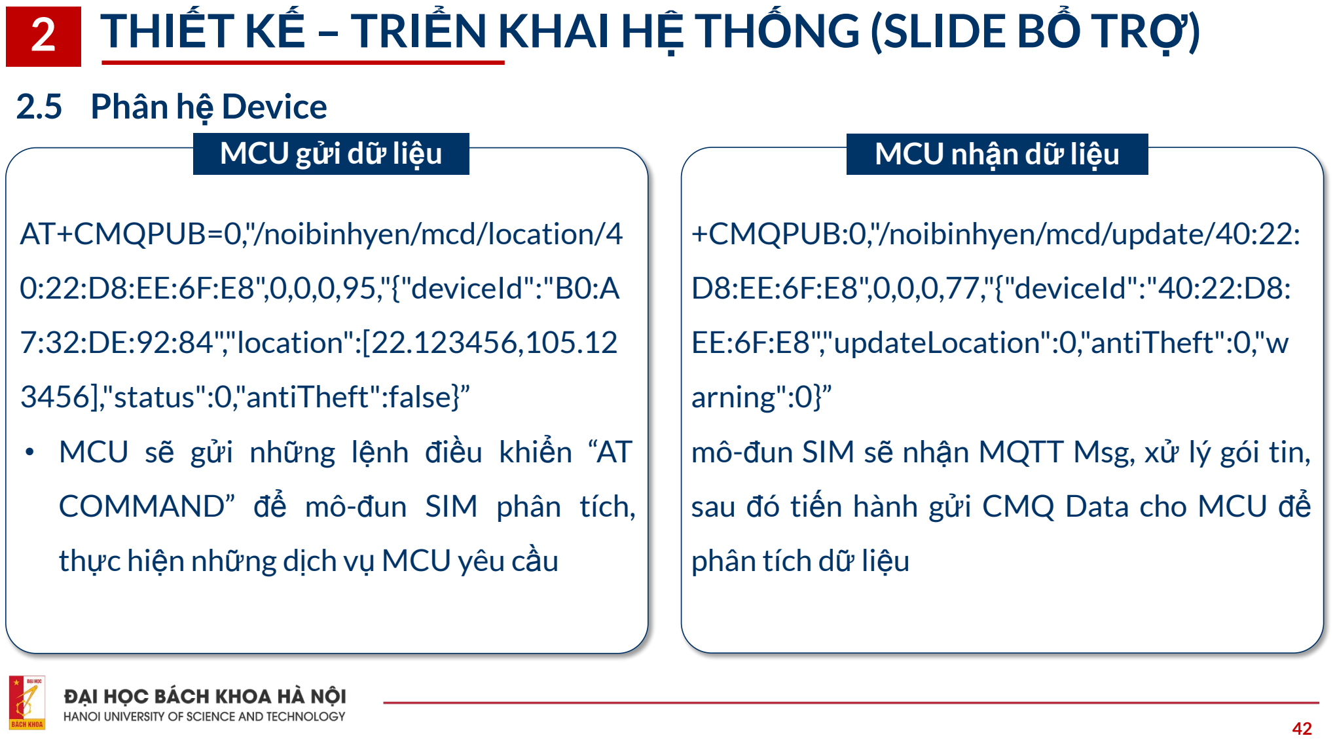
[picture p35: page 42]

42

### 2.5 Phân hệ Device

AT+CMQPUB=0,"/noibinhyen/mcd/location/4

0:22:D8:EE:6F:E8",0,0,0,95,"{"deviceId":"B0:A

7:32:DE:92:84","location":[22.123456,105.12

3456],"status":0,"antiTheft":false}”
- MCU sẽ gửi những lệnh điều khiển “AT

COMMAND” để mô-đun SIM phân tích,

thực hiện những dịch vụ MCU yêu cầu

+CMQPUB:0,"/noibinhyen/mcd/update/40:22:

D8:EE:6F:E8",0,0,0,77,"{"deviceId":"40:22:D8:

EE:6F:E8","updateLocation":0,"antiTheft":0,"w

arning":0}”

mô-đun SIM sẽ nhận MQTT Msg, xử lý gói tin, sau đó tiến hành gửi CMQ Data cho MCU để

phân tích dữ liệu

MCU gửi dữ liệu | MCU nhận dữ liệu

## 2 THIẾT KẾ – TRIỂN KHAI HỆ THỐNG (SLIDE BỔ TRỢ)

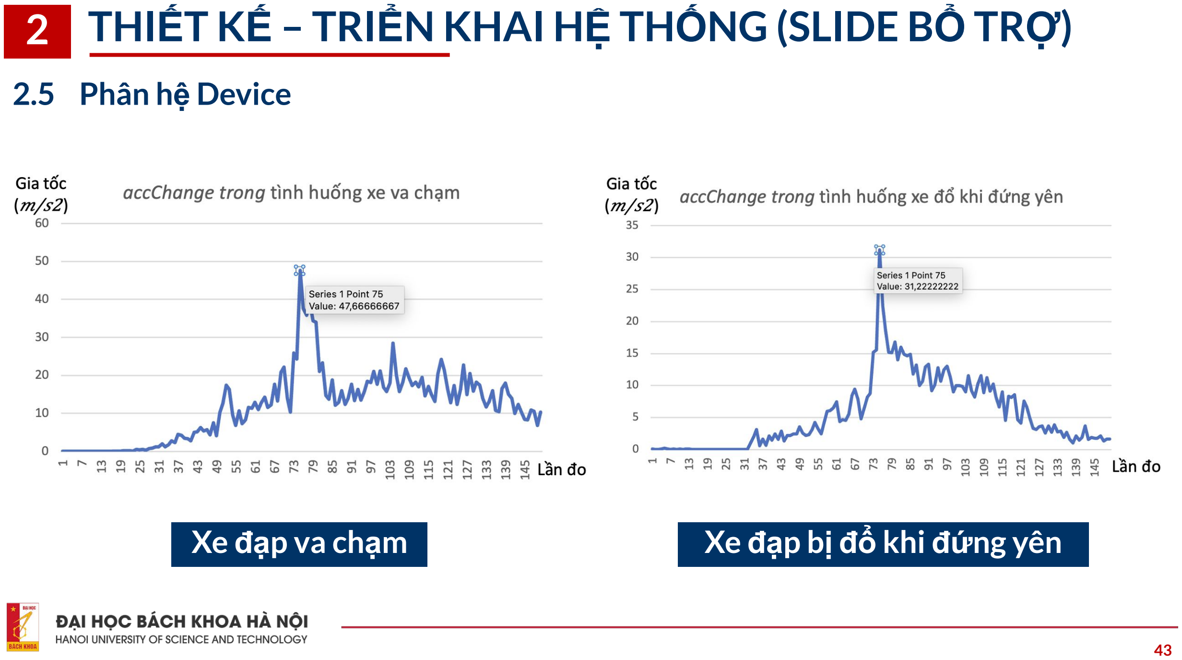
[picture p36: page 43]

43

Xe đạp va chạm | Xe đạp bị đổ khi đứng yên

### 2.5 Phân hệ Device

## 2 THIẾT KẾ – TRIỂN KHAI HỆ THỐNG (SLIDE BỔ TRỢ)

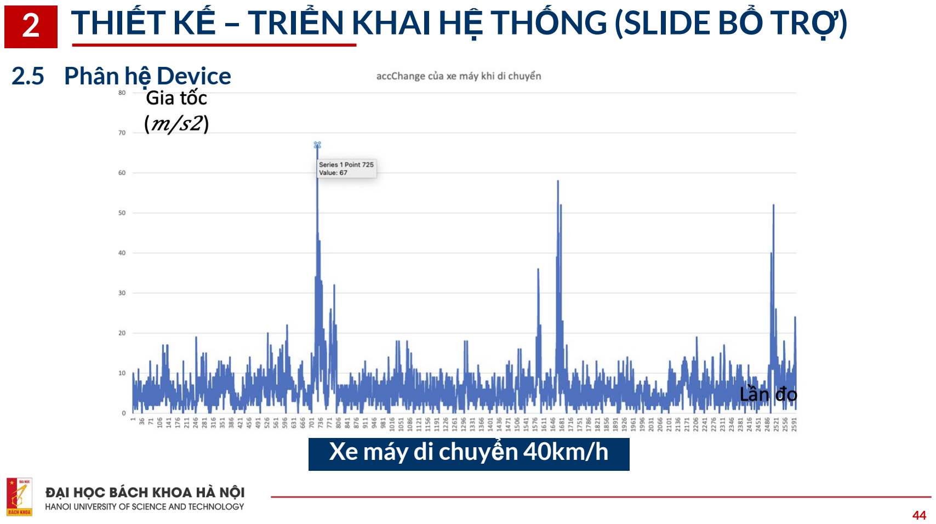
[picture p37: page 44]

44

Xe máy di chuyển 40km/h

### 2.5 Phân hệ Device

45

## 2 THIẾT KẾ – TRIỂN KHAI HỆ THỐNG (SLIDE BỔ TRỢ)

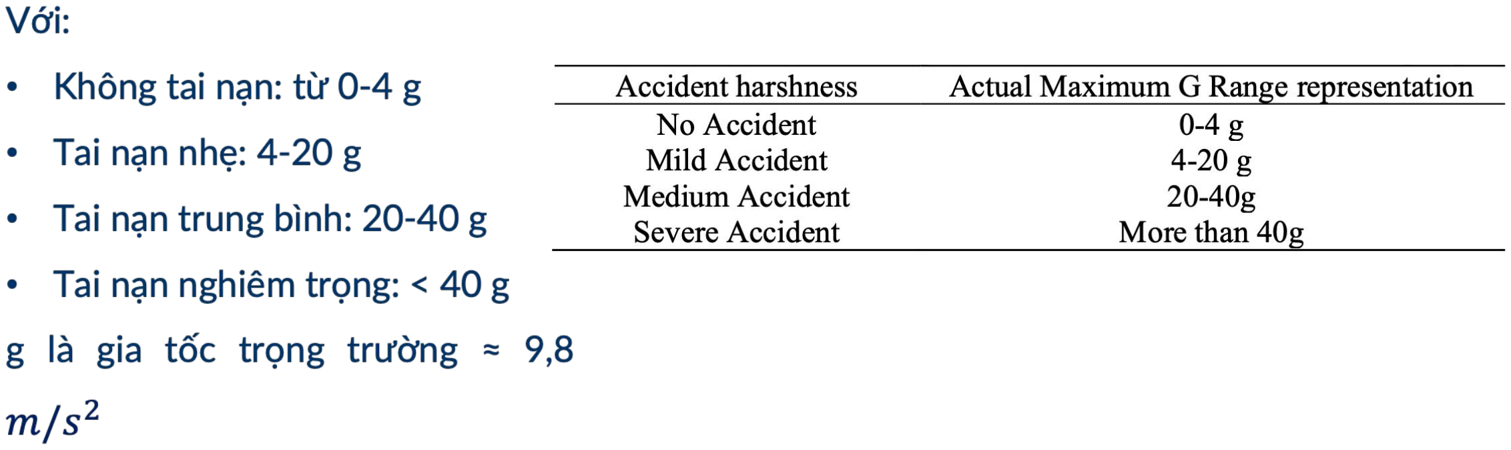
[picture p38: figure]

Tham khảo giá trị ngưỡng về phát hiện tai nạn

46

## TÀI LIỆU THAM KHẢO

- Sudha Senthilkumar, K. Brindha, Shashank Bhandari, "Vehicle

accident management and control system using MQTT,"
