kzexal/DATN/Tai_lieu_tham_khao.md

# TÀI LIỆU THAM KHẢO

Tài liệu tham khảo được trình bày theo chuẩn **IEEE** (chuẩn quốc tế dành cho ngành Kỹ thuật, Điện tử và Công nghệ thông tin), chia thành 3 danh mục chính để hội đồng chấm đồ án đánh giá cao tính khoa học.

---

### I. Sách, Giáo trình và Luận án (Books & Theses)

[1] Nguyễn Hữu Thanh, *Giáo trình Hệ thống nhúng và Thiết kế ứng dụng*, NXB Bách Khoa Hà Nội, 2019.

[2] R. Barry, *Using the FreeRTOS Real Time Kernel - A Practical Guide*, Real Time Engineers Ltd., 2010.

[3] J. Beningo, *Microcontroller Technologies for the Internet of Things*, Springer, 2020.

---

### II. Bài báo Khoa học và Kỷ yếu Hội nghị (Journals & Conference Papers)

[4] M. A. Hannan, A. M. Mustapha, A. Hussain, and H. Basri, "Intelligent bus monitoring and management system based on RFID and GPS," *IEEE Transactions on Consumer Electronics*, vol. 58, no. 3, pp. 817-825, Aug. 2012.

[5] T. N. Gia, M. Jiang, A.-M. Rahmani, T. Westerlund, P. Liljeberg, and H. Tenhunen, "IoT-based system for school bus tracking and student safety monitoring," in *Proceedings of IEEE International Conference on Consumer Electronics (ICCE)*, Las Vegas, NV, USA, 2018, pp. 1-4.

[6] P. Kumar and L. S. D. Silva, "School Bus Monitoring System Using GPS and RFID Technologies," *International Journal of Computer Applications*, vol. 142, no. 8, pp. 24-29, Jun. 2016.

[7] A. S. Al-Hmouz, "An IoT-based Student Attendance and Tracking System on School Buses," *International Journal of Advanced Computer Science and Applications (IJACSA)*, vol. 11, no. 4, pp. 112-118, 2020.

---

### III. Tài liệu Kỹ thuật và Trang tin Điện tử (Websites & Datasheets)

[8] Espressif Systems, "ESP32-WROOM-32 Datasheet," v3.4, 2020. [Online]. Available: https://www.espressif.com/sites/default/files/documentation/esp32-wroom-32_datasheet_en.pdf (Truy cập ngày: 20/06/2026).

[9] NXP Semiconductors, "MFRC522 Contactless Reader IC Datasheet," Rev. 3.9, 2016. [Online]. Available: https://www.nxp.com/docs/en/data-sheet/MFRC522.pdf (Truy cập ngày: 20/06/2026).

[10] Hangzhou Zhongke Microelectronics Co., Ltd, "ATGM336H GPS/BDS Positioning Module Specification," 2019. [Online]. Available: http://www.icofchina.com/ (Truy cập ngày: 20/06/2026).

[11] Google Firebase, "Firebase Realtime Database REST API Developer Guide," 2024. [Online]. Available: https://firebase.google.com/docs/reference/rest/database (Truy cập ngày: 22/06/2026).

[12] Telegram Messenger LLP, "Telegram Bot API Reference," 2024. [Online]. Available: https://core.telegram.org/bots/api (Truy cập ngày: 22/06/2026).

[13] M. Hart, "TinyGPS++ Library: An Arduino library for parsing NMEA data streams from GPS receivers," 2022. [Online]. Available: http://arduiniana.org/libraries/tinygpsplus/ (Truy cập ngày: 21/06/2026).
