kzexal/DATN/[SLIDE]_Đào Bá Khánh_ĐATN_Thiết kế, triển khai hệ thống IOT phát hiện và cảnh báo mất trộm, tai nạn xe máy.pptx.pptx

ĐỒ ÁN TỐT NGHIỆP CỬ NHÂN

## Slide 2

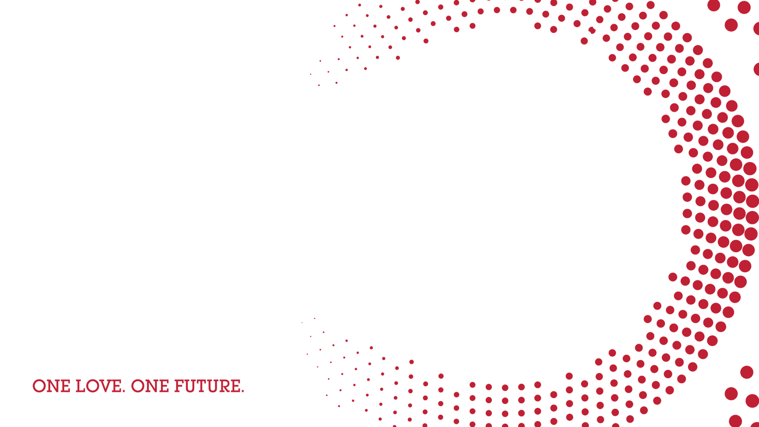
[picture p99: figure]

THIẾT KẾ THIẾT BỊ GIÁM SÁT HỌC SINH LÊN XUỐNG XE BUÝT ĐƯA ĐÓN

Sinh viên: Bùi Duy Khánh
MSSV: 20224017
GVHD: ThS. Đinh Thị Nhung

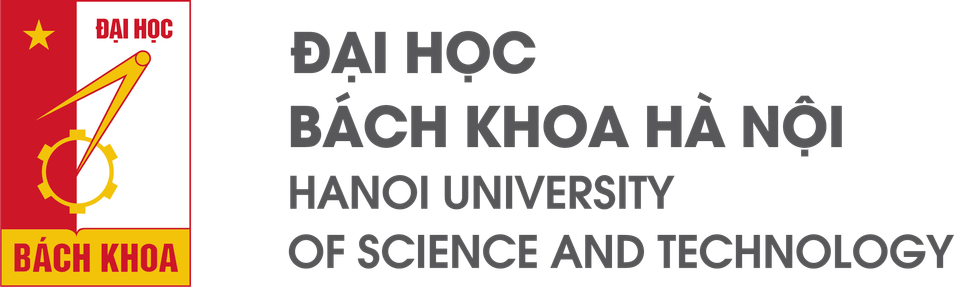
[picture p100: figure]

Đề tài:

## Slide 3

NỘI DUNG TRÌNH BÀY

  1. TỔNG QUAN DỰ ÁN
  2. THIẾT KẾ - TRIỂN KHAI HỆ THỐNG
  3. KIỂM THỬ - ĐÁNH GIÁ
  4. KẾT LUẬN - HƯỚNG PHÁT TRIỂN

‹#›

‹#›

## Slide 4

TỔNG QUAN DỰ ÁN

## Slide 5

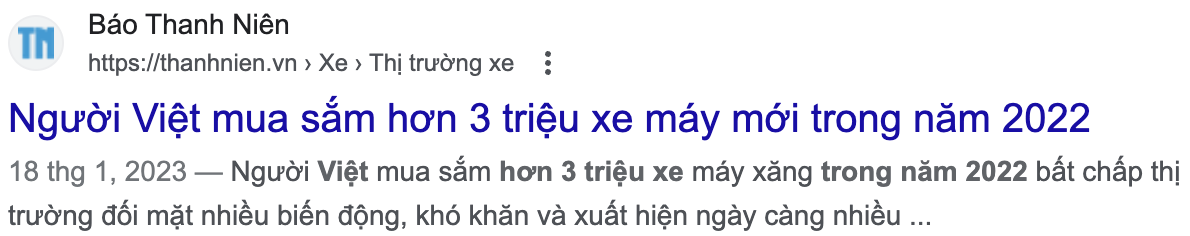
[picture p101: figure]
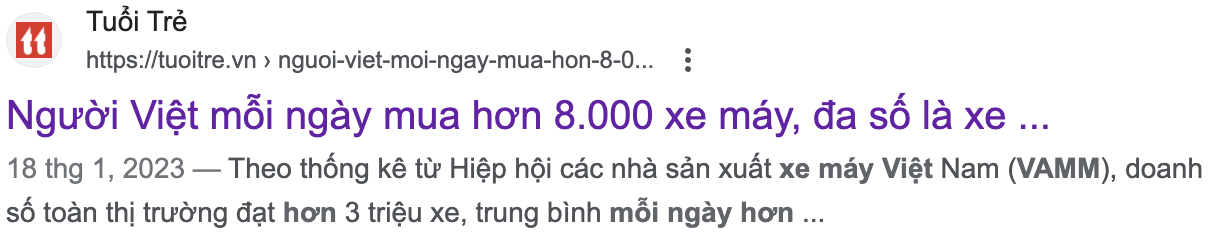
[picture p102: figure]

Đặt vấn đề

  - Bị bỏ quên trên xe buýt đưa đón.
  - Điểm danh thủ công dễ sai sót khi số lượng học sinh đông.
  - Phụ huynh thiếu thông tin để kiểm soát.

CẦN HỆ THỐNG TỰ ĐỘNG ĐIỂM DANH VÀ CẢNH BÁO VỊ TRÍ TỨC THỜI.

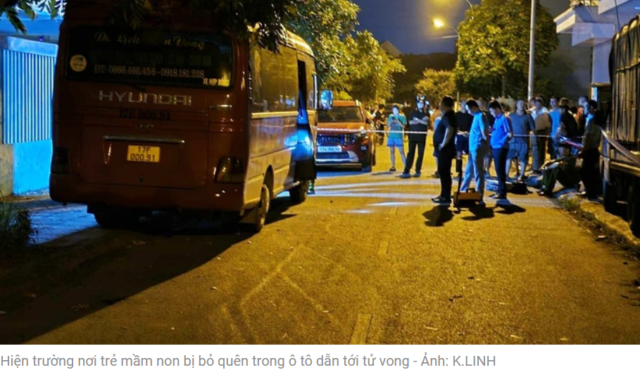
[picture p103: figure]
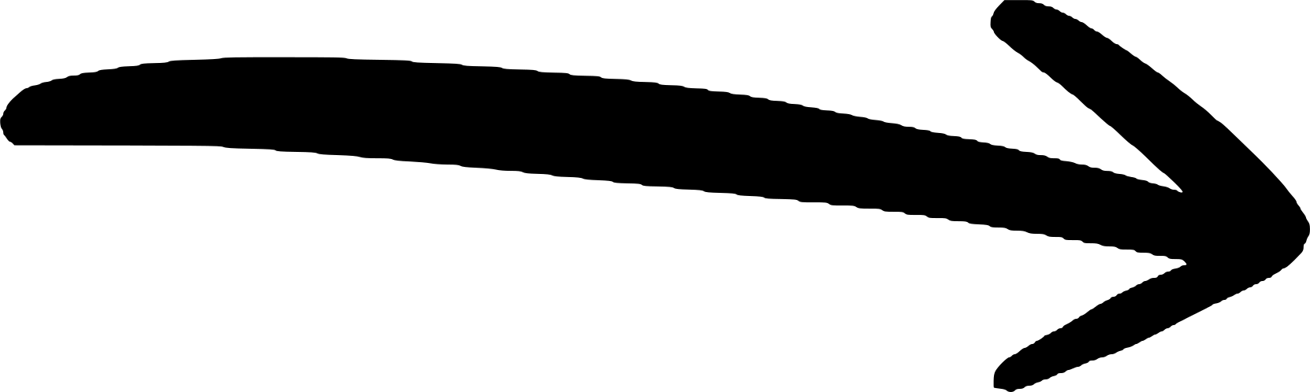
[picture p104: figure]

‹#›

Notes: Xe máy là một ptien linh hoạt, và ptien phổ biến nhất tại VN. Với tốc độ gia tang đáng kể.
Hiệp hội các nhà sản xuất xe máy Việt Nam (VAMM) …
Đi kèm với sự phổ biến, linh hoạt, di động đó, có rất nhiều vấn đề xoay quanh xe máy,
‹#›

## Slide 6

So sánh với các giải pháp đang có trên thị trường

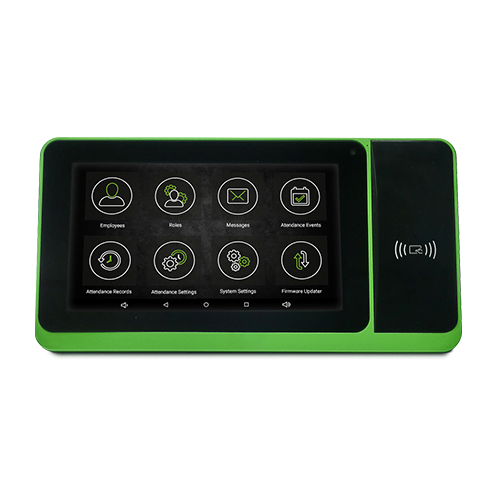
[picture p105: figure]

Máy quẹt thẻ kiểm soát cửa/chấm công

  - Ưu điểm: Nhận diện thẻ RFID/Vân tay rất tốt, hoạt động bền bỉ.
  - Nhược điểm: Thiết kế cho vị trí cố định (tòa nhà). Không có GPS nên không cung cấp được vị trí xe.

Điểm danh thủ công (Sổ sách/Giám thị)

  - Ưu điểm: Không tốn chi phí trang thiết bị.
  - Nhược điểm: Rất dễ sai sót khi đông học sinh. Phụ huynh bị động, không thể theo dõi.

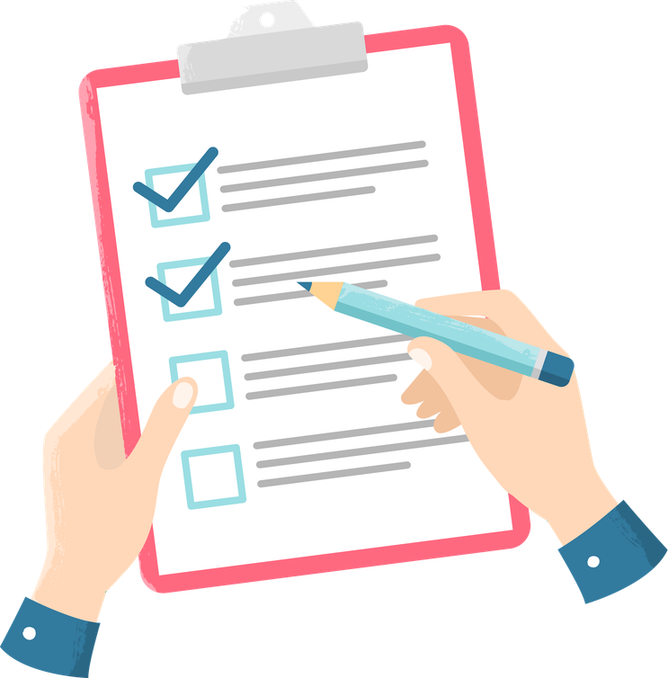
[picture p106: figure]
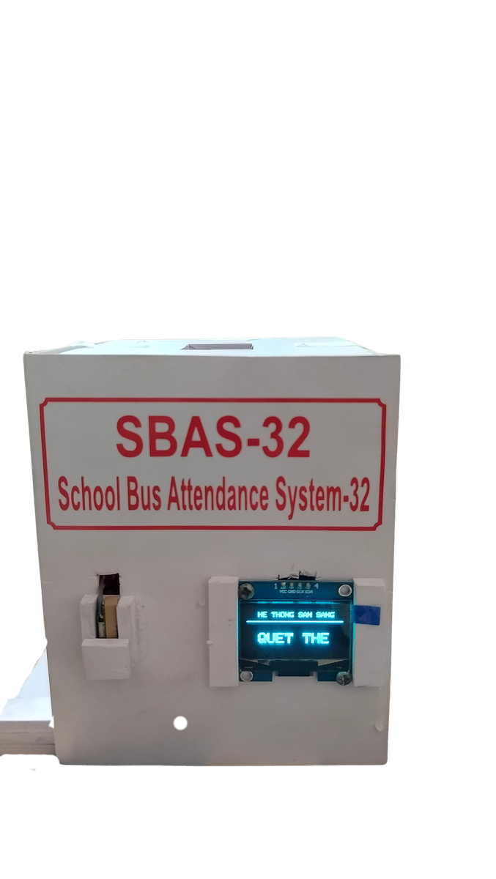
[picture p107: figure]

Giải pháp của đồ án (Thiết bị SBAS-32)

  - Ưu điểm: Tích hợp 2 trong 1: Định danh (RFID) + Định vị (GPS). Cơ động cho xe buýt, thông báo tọa độ tức thời qua Telegram. Chi phí linh kiện thấp (~600k VNĐ).
  - Nhược điểm: Đang ở bản nguyên mẫu, phụ thuộc vào kết nối Wi-Fi di động.

‹#›

Notes: VĐ1: trên thị trường có một số đơn vị có sản phẩm giải quyết, đều có những ưu, nhược điểm khác nhau
VĐ2: trên thị trg chưa có
-> Cần phải phát triển 1 hệ thống có thể giải quyết đồng thời 2 vấn đề trên.
VĐ1: định vị xe, báo cơ quan chức năng.
VĐ2: định vị vị trí tai nạn, kịp thời giúp đỡ nạn nhân

‹#›

## Slide 7

Xây dựng hệ thống IOT có khả năng phát hiện và thông báo thời gian thực:
  - Học sinh lên/xuống xe (Nhận diện thẻ).
  - Vị trí hành trình của xe buýt (Định vị toàn cầu).

Mục tiêu của đồ án tốt nghiệp

‹#›

Notes: Dự án to, cần có nhiều giai đoạn phát triển để thành 1 sp hoàn chỉnh.
Xác định ĐATN là gia đoạn đầu của dự án.
với gian đoạn này , mục tiêu mong muốn đạt được:
‹#›

## Slide 8

THIẾT KẾ - TRIỂN KHAI HỆ THỐNG

## Slide 9

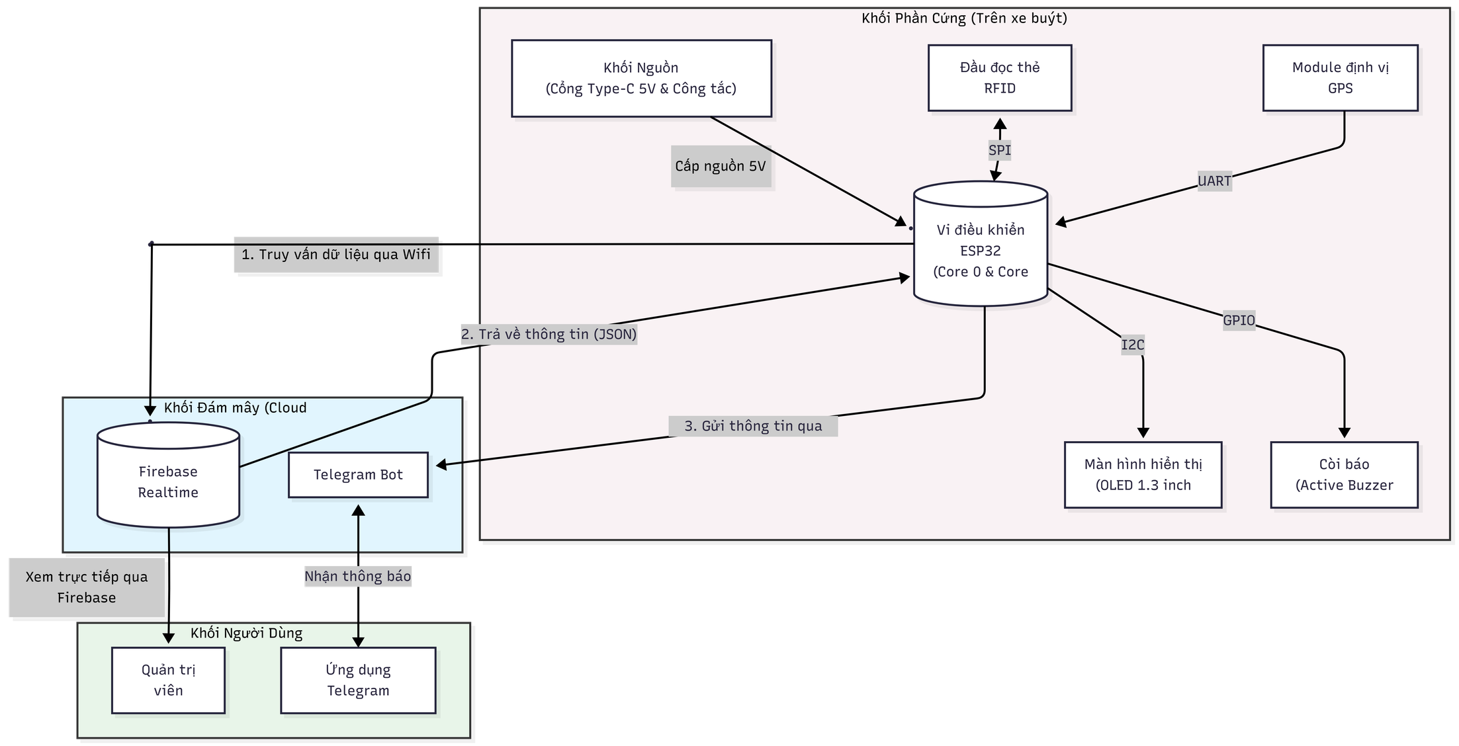
[picture p108: figure]

Sơ đồ tổng quan của hệ thống

‹#›

Notes: ‹#›

## Slide 10

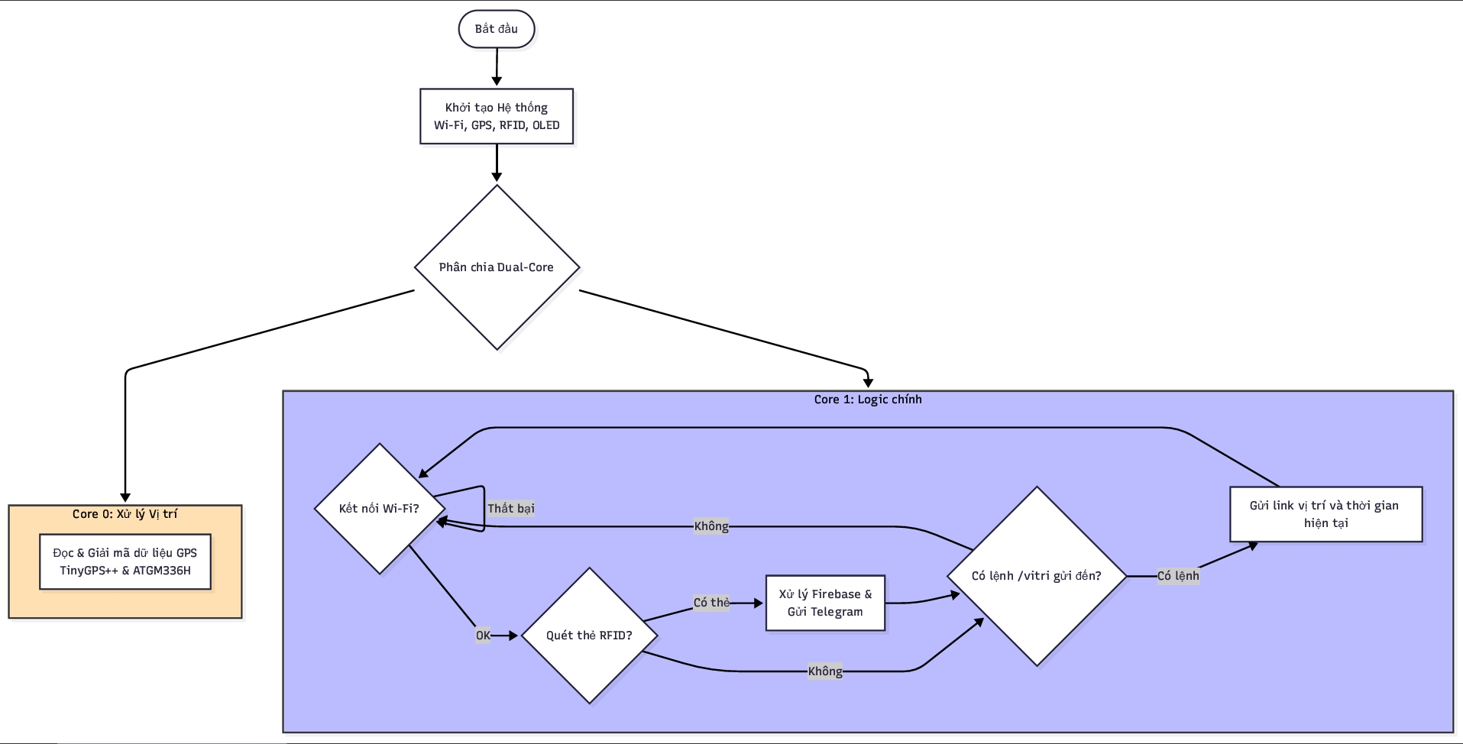
[picture p109: figure]

Luồng hoạt động chính của thiết bị

‹#›

Notes: ‹#›

## Slide 11

Phân hệ Device - Tổng quan & Luồng hoạt động

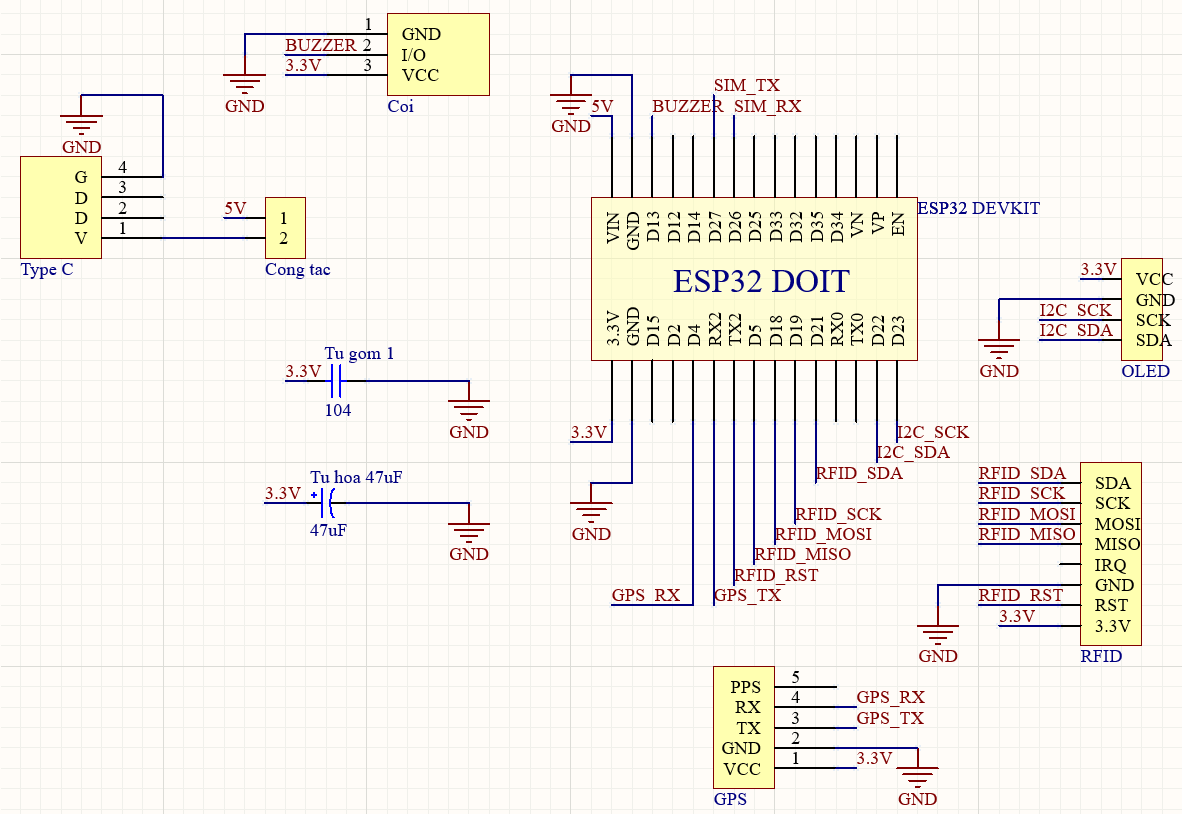
[picture p110: figure]

Sơ đồ nguyên lý

‹#›

Notes: ‹#›

## Slide 12

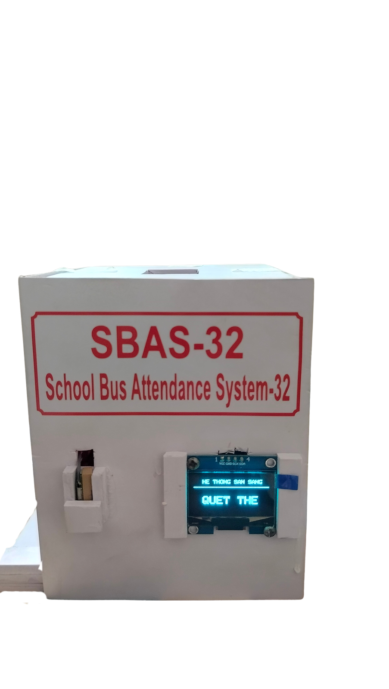
[picture p111: figure]

Phân hệ Device - Tổng quan & Luồng hoạt động

Mạch in và hộp phần cứng

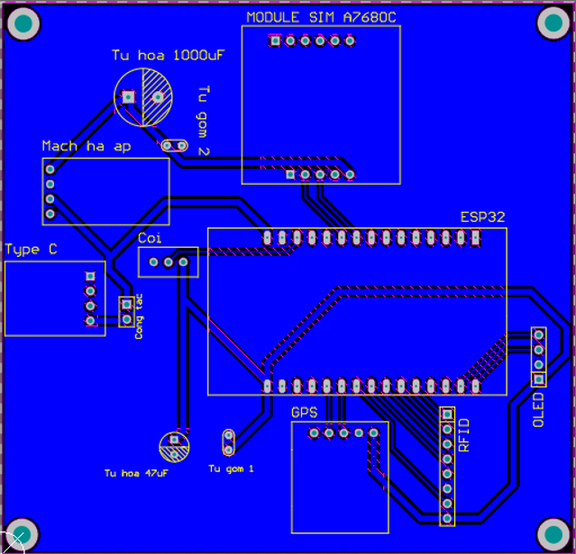
[picture p112: figure]
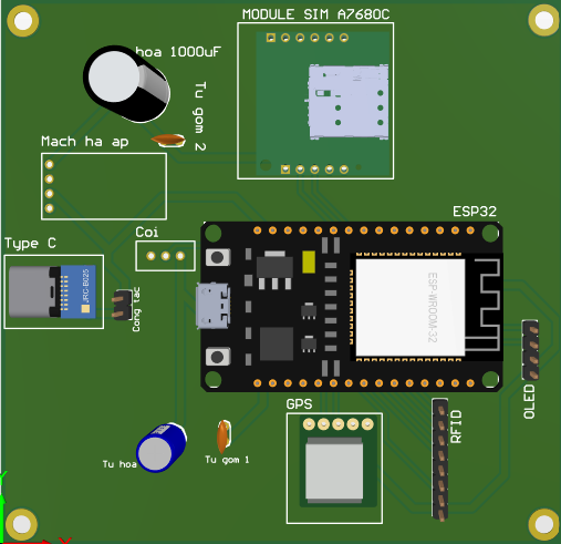
[picture p113: figure]
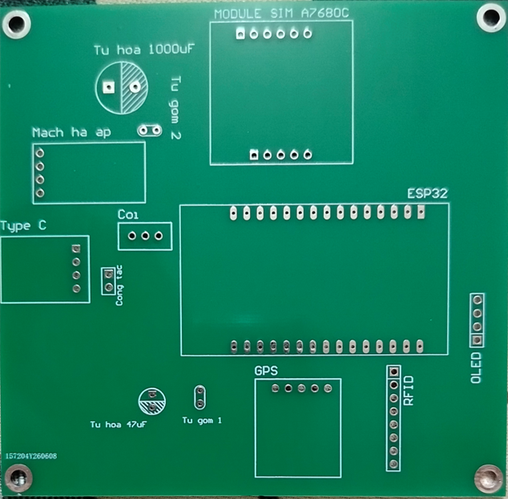
[picture p114: figure]
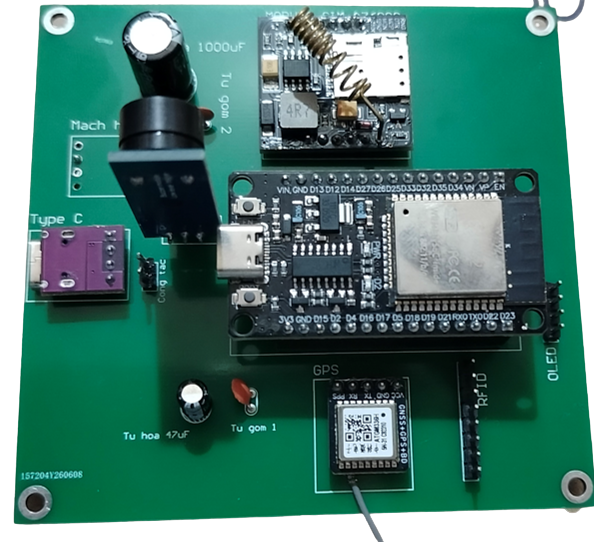
[picture p115: figure]
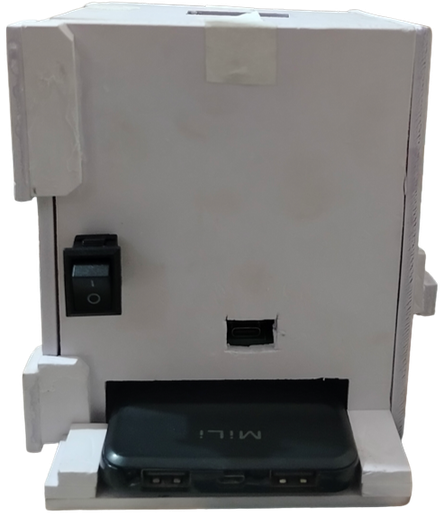
[picture p116: figure]
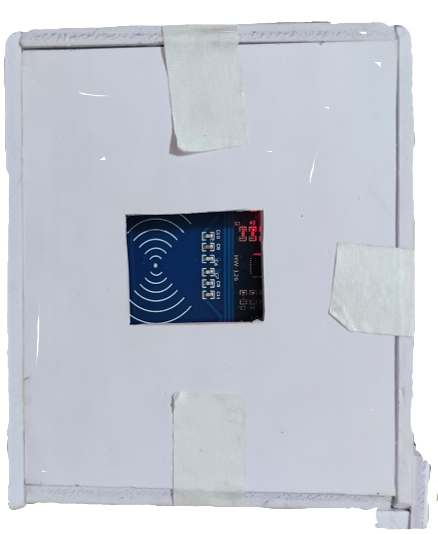
[picture p117: figure]

‹#›

Notes: ‹#›

## Slide 13

Phân hệ Database & Telegram Bot

Firebase Realtime Database:
  - Đóng vai trò Database trung tâm của hệ thống.
  - Cập nhật trạng thái (In/Out) theo thời gian thực dạng JSON.

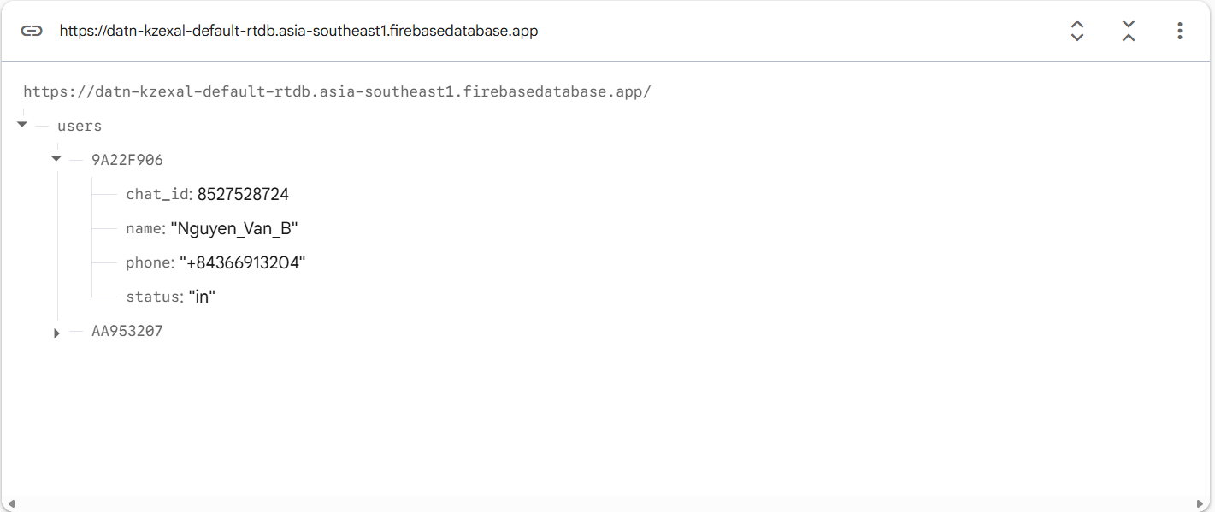
[picture p118: figure]

‹#›

Notes: Server – backend sử dụng firestore firebase làm database
Kế thừa từ 1 dự án startup mà em support, vì có mô hình tương tự. Chỉ config lại key của 1 số dịch vụ
Ảnh bên là luồng hoạt động chính

‹#›

## Slide 14

Phân hệ Database & Telegram Bot

Telegram Bot API:
  - Đóng vai trò liên lạc giữa phụ huynh và thiết bị.
  - Thông báo cho phụ huynh về thông tin học sinh lên xuống xe.
  - Phản hồi khi nhận được yêu cầu vị trí của phụ huynh.

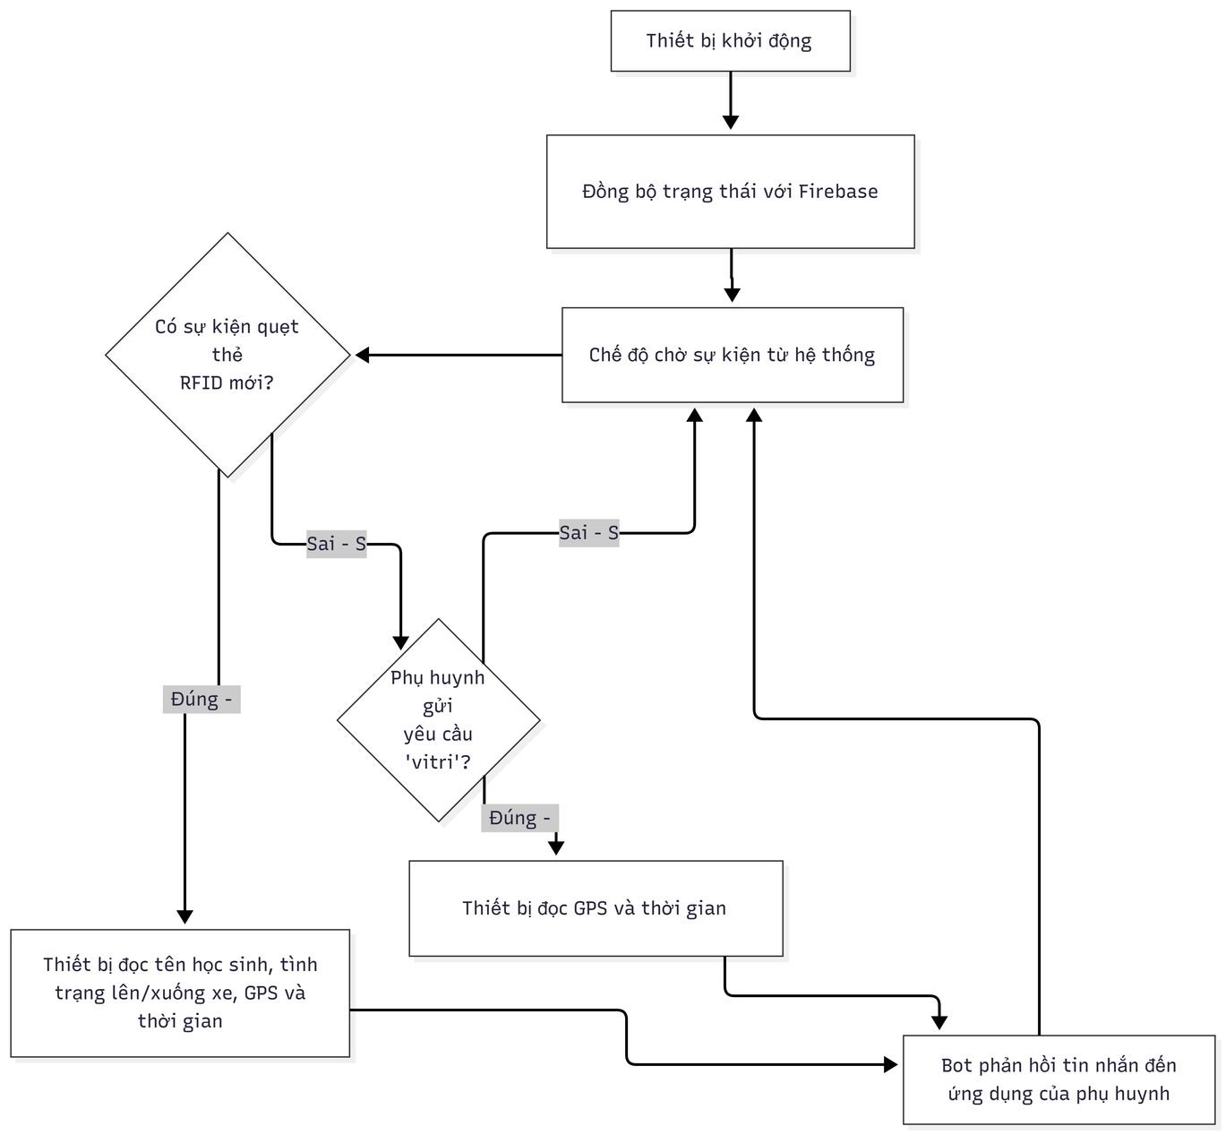
[picture p119: figure]
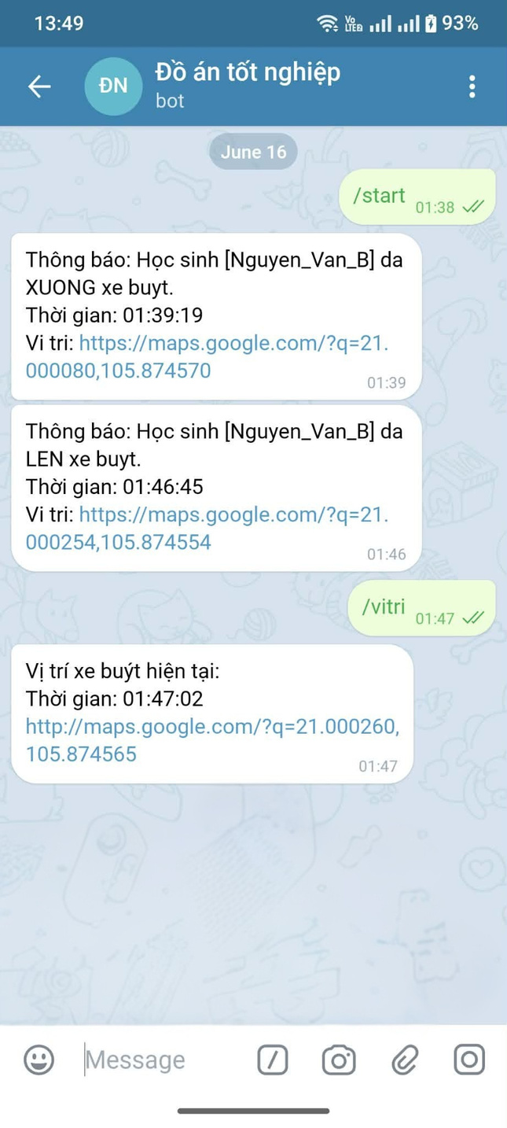
[picture p120: figure]

‹#›

Notes: Server – backend sử dụng firestore firebase làm database
Kế thừa từ 1 dự án startup mà em support, vì có mô hình tương tự. Chỉ config lại key của 1 số dịch vụ
Ảnh bên là luồng hoạt động chính

‹#›

## Slide 15

KIỂM THỬ - ĐÁNH GIÁ

## Slide 16

  - Điều kiện 1: Xe di chuyển thực tế, thiết bị được đặt chỗ thoáng không bị cản sóng ăng ten GPS, có sóng Wi-Fi ổn định.
  - Điều kiện 2: Xe đi qua khu vực sóng vệ tinh và sóng điện thoại yếu.
  - Hệ thống: Thiết bị được cấp nguồn xuyên suốt, tài khoản telegram của phụ huynh đã được đăng kí.

Kiểm thử và đánh giá

‹#›

Notes: DB: Dữ liệu được lưu dưới dạng các document, thuộc Collections
‹#›

## Slide 17

Kiểm thử tính năng nhận diện và cập nhật

  - Hành động: Học sinh quẹt thẻ RFID vào thiết bị (Thực hiện 15 lần cách nhau khoảng ngẫu nhiên).
  - Kết quả kỳ vọng:
    - Kỳ vọng 1: Còi kêu bíp, màn hình OLED báo tên + "LÊN/XUỐNG XE".
    - Kỳ vọng 2: Trường status trên Firebase cập nhật đổi trạng thái (In <-> Out).
    - Kỳ vọng 3: Điện thoại nhận được thông báo qua Telegram.
  - Số lần kiểm thử: 15 lần
Kết quả thực tế trong Điều kiện 1: Số lần đạt 15/15. Tỉ lệ lỗi: 0%.
Kết quả thực tế trong Điều kiện 2: Số lần đạt 5/15. Tỉ lệ lỗi: 67%.

‹#›

Notes: MobiApp sử dụng Flutter, build 2 OS cùng 1 base code
Kiến trúc: dựa trên Bloc Pattern : tách bus khỏi UI, phân chia các repo, service xử lí data riêng
Ảnh bên là luồng hoạt động chính
‹#›

## Slide 18

Kiểm thử tính năng thông báo và truy vấn

  - Hành động: Phụ huynh nhắn lệnh /vitri rồi đợi phản hồi vị trí xe buýt.
  - Kết quả kỳ vọng:
    - Kỳ vọng 1: Hệ thống nhận được tin nhắn của phụ huynh.
    - Kỳ vọng 2: App Telegram nhận được tin nhắn phản hồi, kèm đường link Google Maps.
    - Kỳ vọng 3: Sai số GPS thấp < 20 mét.
  - Số lần kiểm thử: 15 lần
  - Kết quả đo thực tế
Kết quả thực tế trong Điều kiện 1: Số lần đạt 13/15. Tỉ lệ lỗi: 13%.
Kết quả thực tế trong Điều kiện 2: Số lần đạt 3/15. Tỉ lệ lỗi: 80%

‹#›

Notes: MobiApp sử dụng Flutter, build 2 OS cùng 1 base code
Kiến trúc: dựa trên Bloc Pattern : tách bus khỏi UI, phân chia các repo, service xử lí data riêng
Ảnh bên là luồng hoạt động chính
‹#›

## Slide 19

KẾT LUẬN - HƯỚNG PHÁT TRIỂN

## Slide 20

  - Đạt được:
    - Xây dựng thành công mô hình IOT giải quyết 2 vấn đề đặt ra (Điểm danh & Định vị).
    - Hệ thống chạy đa luồng ổn định, truyền nhận dữ liệu thời gian thực tốt.
  - Hạn chế:
    - Phụ thuộc hoàn toàn vào kết nối mạng Wi-Fi trên xe.
    - Chưa có phương pháp thay thế khi bị mất mạng.
    - Kích thước nguyên mẫu mạch PCB vẫn còn khá lớn.

Kết luận

‹#›

Notes: Một số màn hình trong App
‹#›

## Slide 21

  - Phân hệ Device:
    - Tích hợp module SIM 4G để gửi SMS thông báo dự phòng.
    - Tích hợp khe cắm thẻ nhớ MicroSD để lưu trữ dữ liệu offline.
    - Tối ưu kích thước mạch sang linh kiện dán SMD.
    - Cải thiện độ chính xác, độ nhạy nhận sóng GPS.
  - Phân hệ App:
    - Làm ứng dụng cho tài xế/giám thị để thống kê danh sách học sinh trên xe.
    - Làm ứng dụng cho phụ huynh để phát triển thêm nhiều tính năng.

Hướng phát triển

‹#›

Notes: Trên đây là sơ đồ tổng quan của phần cứng, gồm các khối:
Ảnh bên là luồng hoạt động chính.
Phần tính toán các trạng thái cảnh báo được thực hiện ở bước… (chỉ vào), với 2 thuật toán chính:

‹#›

## Slide 22

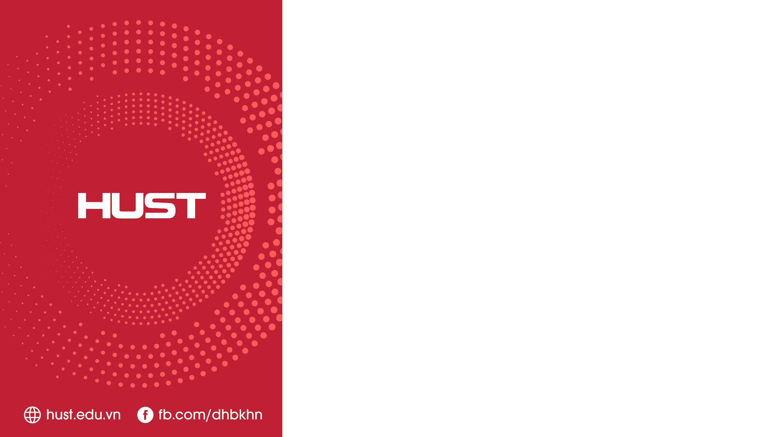
[picture p121: figure]

THANK YOU !

‹#›

## Slide 23

SLIDE BỔ TRỢ

‹#›

## Slide 24

Đối tượng khách hàng & Tiêu chí hệ thống

Đối tượng: Nhà trường, Đơn vị cung cấp dịch vụ đưa đón, Phụ huynh học sinh.
Lợi ích dành cho khách hàng:
  - Tiết kiệm chi phí vận hành
  - Tăng hiệu quả quản lý
  - Đảm bảo an toàn, minh bạch
  - Dễ dàng mở rộng, linh hoạt
  - Nâng cao trải nghiệm người dùng

‹#›

Notes: Trên đây là sơ đồ tổng quan của phần cứng, gồm các khối:
Ảnh bên là luồng hoạt động chính.
Phần tính toán các trạng thái cảnh báo được thực hiện ở bước… (chỉ vào), với 2 thuật toán chính:

‹#›

## Slide 25

Chi phí nguyên mẫu Device

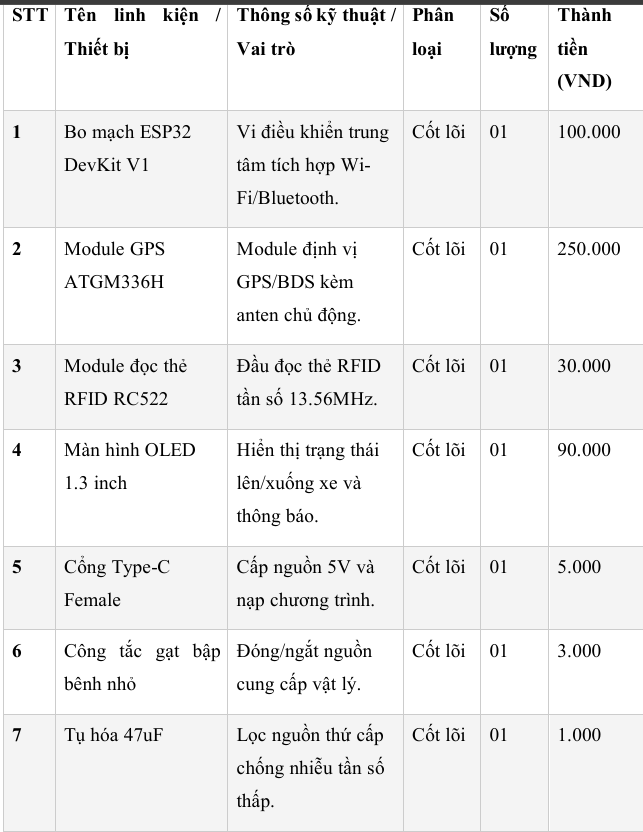
[picture p122: figure]
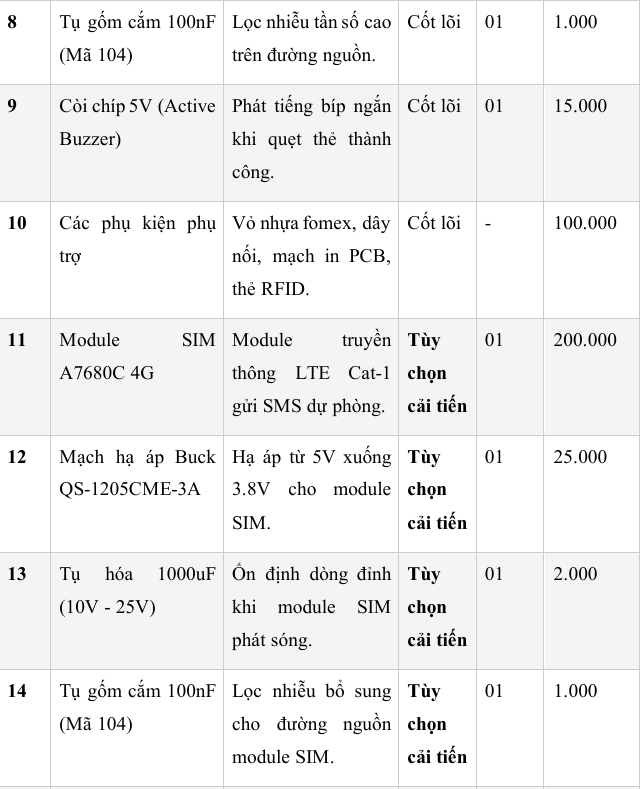
[picture p123: figure]
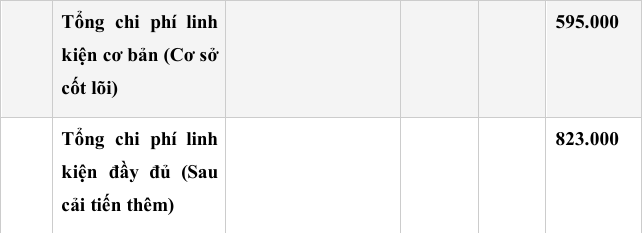
[picture p124: figure]

‹#›

Notes: Trên đây là sơ đồ tổng quan của phần cứng, gồm các khối:
Ảnh bên là luồng hoạt động chính.
Phần tính toán các trạng thái cảnh báo được thực hiện ở bước… (chỉ vào), với 2 thuật toán chính:

‹#›
