kzexal/DATN/bìa.docx

ĐẠI HỌC BÁCH KHOA HÀ NỘI

# TRƯỜNG ĐIỆN - ĐIỆN TỬ

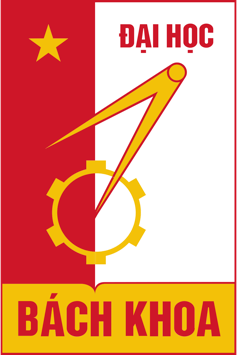
[picture p125: figure]

# BÁO CÁO THỰC TẬP KỸ THUẬT

Đơn vị thực tập:

Công Ty TNHH Điện Tử Meiko Việt Nam

BÙI DUY KHÁNH

## Khanh.bd224017@sis.hust.edu.vn

Ngành Kỹ thuật điện tử - viễn thông

Giảng viên phụ trách: PGS. TS. Nguyễn Hữu Phát

Khoa: Điện tử

HÀ NỘI, 5/2026
