kzexal/DATN/phulucthamkhao.pdf

29

PHỤ LỤC

A. Nhân vật đại diện (Persona)
Tên: Lan
Tuổi: 38
Vai trò: Thủ thư tại Thư viện Trường THPT Trần Phú
Kinh nghiệm: 10 năm quản lý sách thủ công bằng sổ và Excel
Mục tiêu: Đơn giản hóa quy trình nhập – kiểm – xóa sách, tránh thất lạc, minh bạch hóa thông tin.
B. Ngữ cảnh
Trường THPT Trần Phú vừa triển khai phần mềm Quản Lý Thư Viện. Cô Lan chịu trách nhiệm nhập kho sách mới, cập nhật thông tin và theo dõi tình trạng sách.
C. Điều kiện tiên quyết
- Phần mềm đã được kết nối đến cơ sở dữ liệu trung tâm.
- Thủ thư có sẵn thông tin về tựa sách, tác giả, nhà xuất bản và số lượng bản sao.
D. Hậu điều kiện
- Tựa sách và các đầu sách liên quan đã được lưu trữ đúng trong cơ sở dữ liệu.
- Mọi thay đổi (thêm, sửa, xóa, khôi phục) đều được ghi nhận, có thể truy xuất lịch sử.
- Hệ thống luôn duy trì số lượng và tình trạng chính xác của từng đầu sách.
E. Kịch bản sử dụng cụ thể
Tình huống 1: Thêm mới tựa sách và đầu sách
Mục tiêu của người dùng: Nhập một cuốn sách mới vừa được mua vào hệ thống.
Diễn tiến hành động – hệ thống:
- Cô Lan mở ứng dụng Quản lý thư viện.
- Cô Lan chọn nút “Thêm”.
- Cô Lan nhập thông tin: tên sách, tác giả, năm xuất bản, thể loại, nhà xuất bản, số lượng.
- Bấm “Lưu”, hệ thống hiển thị: “Thêm tựa sách thành công”. Khi đó tựa sách sẽ được nhập vào và hệ thống tự tạo đầu sách theo số lượng tương ứng
Lợi ích: Không còn phải gõ lại từng dòng cho mỗi quyển, hệ thống cũng đồng thời tạo các mã đầu sách cho từng đầu sách riêng
Tình huống 2: Cập nhật thông tin tựa sách
Mục tiêu của người dùng: Sửa sai thông tin nhà xuất bản sau khi phát hiện lỗi.

30

Diễn tiến hành động – hệ thống:

- Cô Lan mở ứng dụng Quản lý thư viện.
- Cô Lan tìm tựa sách cần sửa rồi bấm nút “Sửa”
- Cô Lan kiểm tra lại thông tin và sửa lỗi.
- Bấm “Lưu”, hệ thống hiển thị: “Sửa tựa sách thành công”. Khi đó tựa sách sẽ được cập nhật thông tin mới dựa trên những gì cô Lan sửa. Lợi ích: Giảm rủi ro sai sót lưu trữ, có thể kiểm tra lịch sử thay đổi.

Tình huống 3: Xóa đầu sách bị mất
Mục tiêu của người dùng: Xóa một quyển sách bị mất trong đợt kiểm kê. Diễn tiến hành động – hệ thống:
- Cô Lan mở ứng dụng Quản lý thư viện.
- Cô Lan tìm tựa sách cần sửa rồi bấm nút “Xoá”
- Hệ thống hiển thị: “Xoá tựa sách thành công”. Khi đó tựa sách sẽ được xoá khỏi hệ thống thư viện và đưa vào danh sách tựa sách đã xoá.
Lợi ích: Cập nhật tồn kho, có lịch sử kiểm tra khi cần đối chiếu.

Tình huống 4: Khôi phục tựa sách
Mục tiêu của người dùng: Khôi phục lại tựa sách đã xóa nhầm trong đợt kiểm kê trước.
Diễn tiến hành động – hệ thống:
- Cô Lan mở ứng dụng Quản lý thư viện.
- Cô Lan chọn nút “Danh sách đã xoá”, rồi chọn tựa sách cần khôi phục.
- Bấm “Khôi phục”. Hệ thống hiển thị “Khôi phục tựa sách thành công”.
Lợi ích: Trả lại tựa sách về tình trạng hoạt động, tiết kiệm thao tác nhập lại.
F. Lợi ích dành cho Chủ Đầu Tư:
- Tiết kiệm chi phí vận hành: Tự động hóa các bước nhập, sửa, xóa sách giảm thiểu nhân công thủ công và sai sót, từ đó tối ưu hóa chi phí nhân sự.
- Tăng hiệu quả quản lý: Giao diện trực quan và luồng tác nghiệp chuẩn hóa giúp giảm thời gian xử lý nghiệp vụ, nâng cao năng suất làm việc.
- Đảm bảo an toàn, minh bạch: Kiểm soát track log giúp kiểm tra dễ dàng và đảm bảo tính minh bạch trong quá trình vận hành.
- Tính mở rộng và linh hoạt: Kiến trúc hệ thống cho phép dễ dàng nâng cấp, thêm chức năng mới (ví dụ: tích hợp mã vạch, quản lý độc giả, báo mượn trả sách) theo nhu cầu phát triển.
- Nâng cao trải nghiệm người dùng: Thủ thư thao tác nhanh chóng, giảm được áp lực công việc, từ đó cải thiện chất lượng dịch vụ cho người đọc.
