kzexal/DATN/thực tập/Xac_nhan_thuc_tap.pdf

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

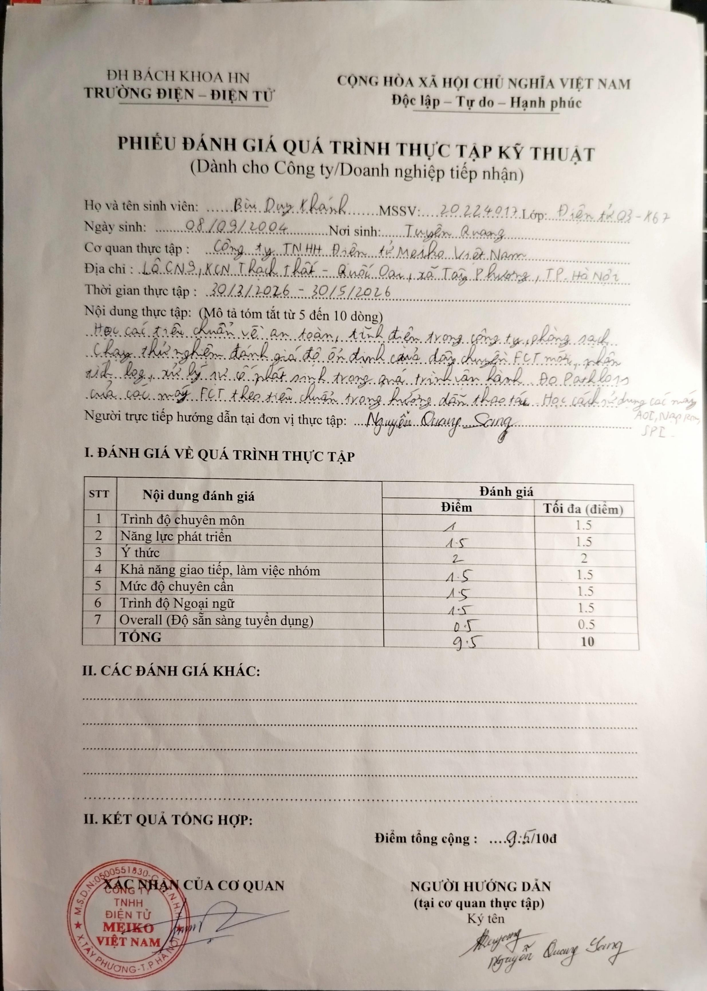
[picture p142: page 1]
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
