kzexal/DATN/module-coi-chip-3-5v-1.webp

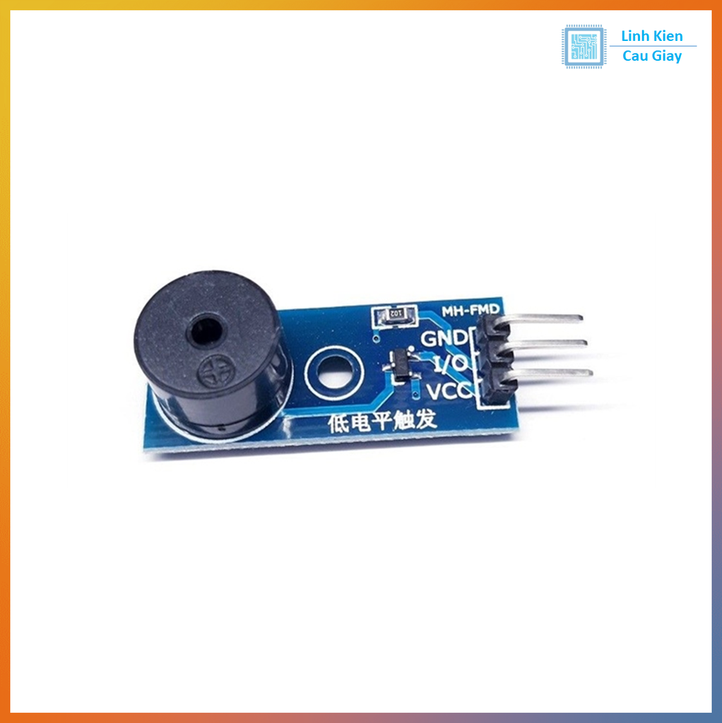
module-coi-chip-3-5v-1.webp
