kzexal/DATN/Ảnh datn-20260623T182437Z-3-001/esp32.jpg

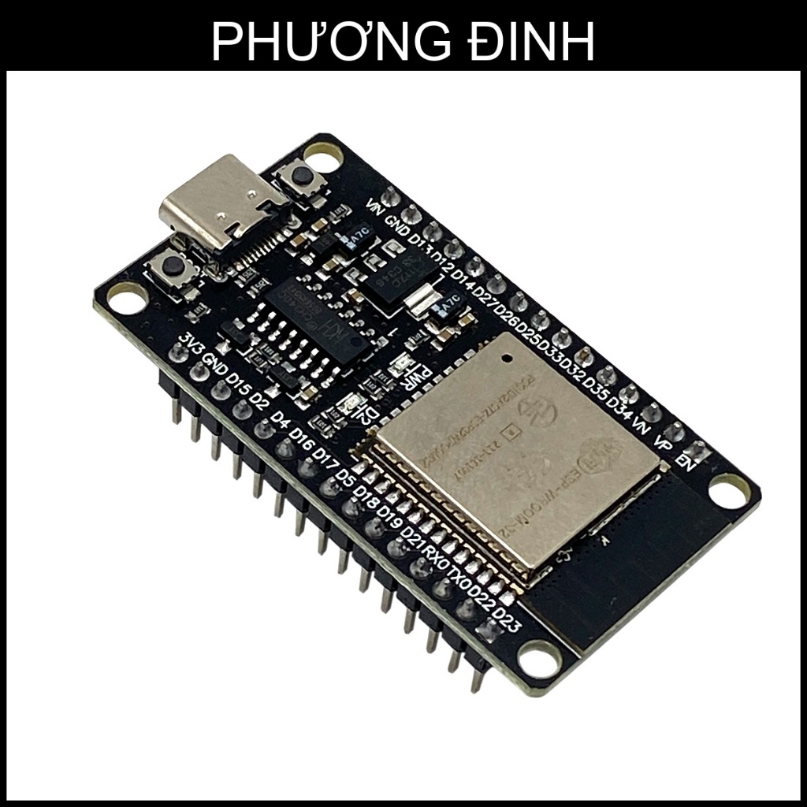
Ảnh datn-20260623T182437Z-3-001/esp32.jpg
