kzexal/DATN/Ảnh datn-20260623T182437Z-3-001/oled.jpg

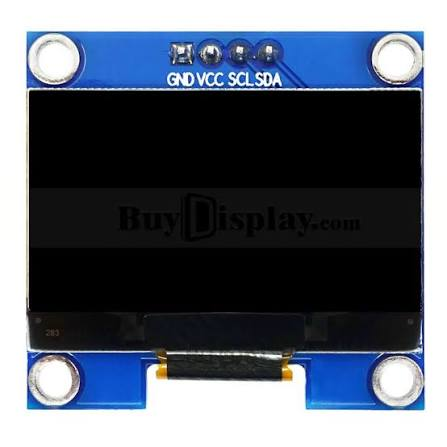
Ảnh datn-20260623T182437Z-3-001/oled.jpg
