kzexal/DATN/Ảnh datn-20260623T182437Z-3-001/RFID.jpg

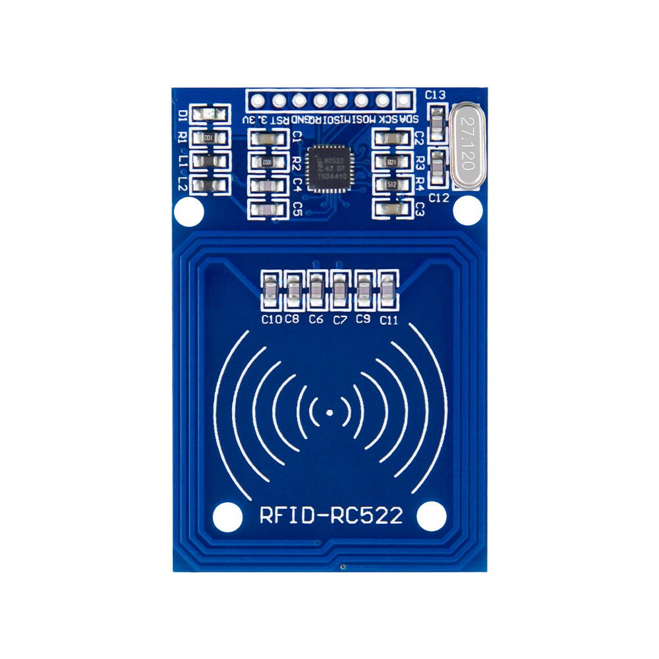
Ảnh datn-20260623T182437Z-3-001/RFID.jpg
