kzexal/DATN/Ảnh datn-20260623T182437Z-3-001/Screenshot_20260626-121107.png

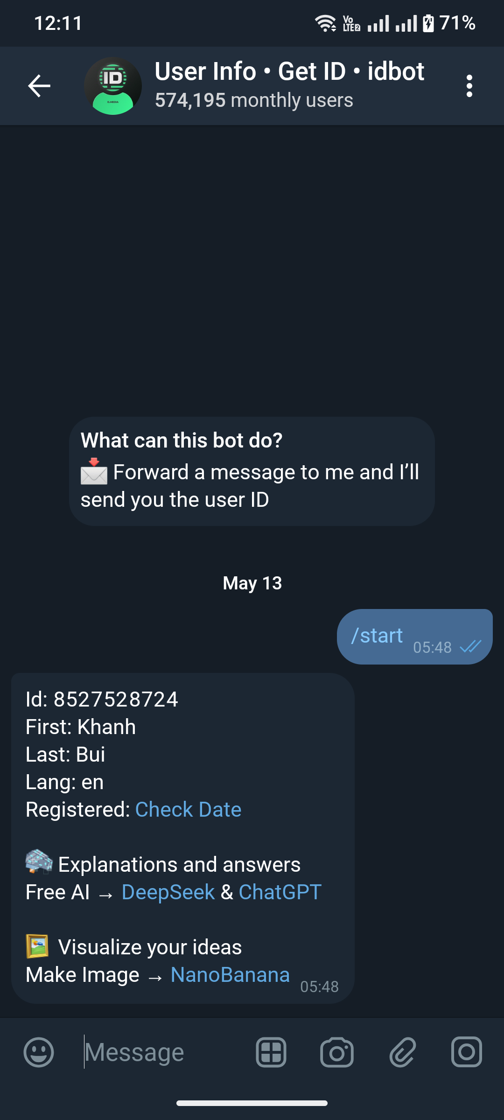
Ảnh datn-20260623T182437Z-3-001/Screenshot_20260626-121107.png
