kzexal/DATN/Ảnh datn-20260623T182437Z-3-001/UC5.png

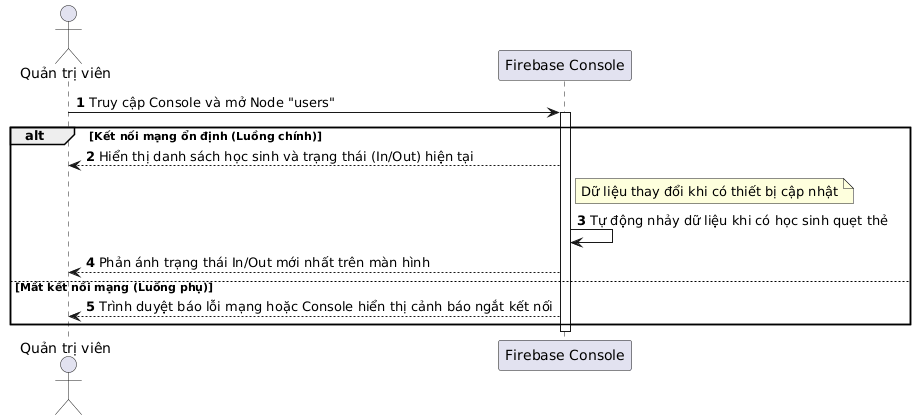
Ảnh datn-20260623T182437Z-3-001/UC5.png
