kzexal/DATN/Ảnh datn-20260623T182437Z-3-001/Ảnh datn/IMG20260622223504.jpg

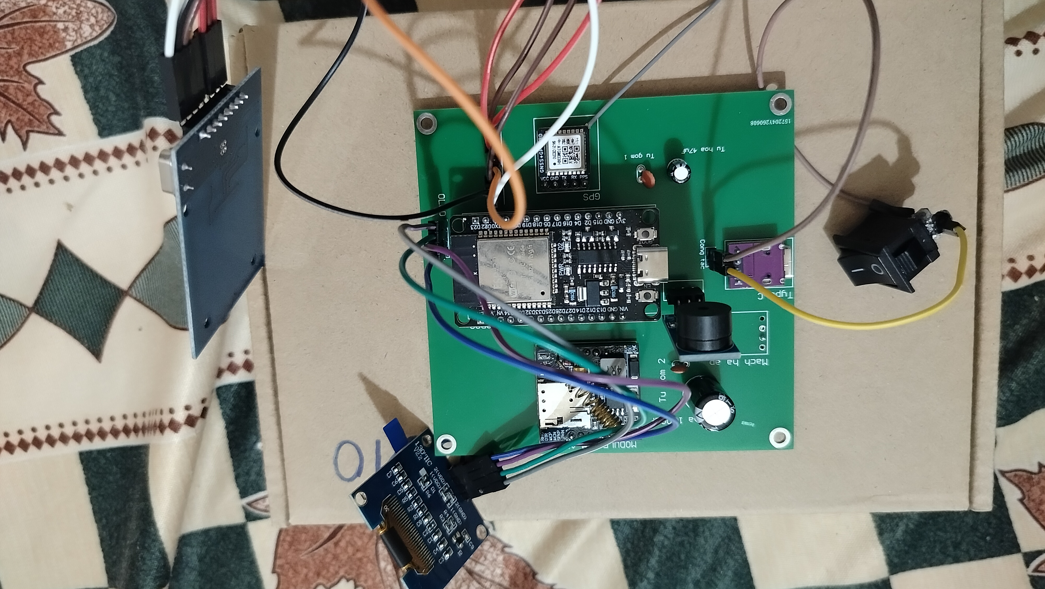
Ảnh datn-20260623T182437Z-3-001/Ảnh datn/IMG20260622223504.jpg
