kzexal/DATN/Ảnh datn-20260623T182437Z-3-001/Ảnh datn/IMG20260625043110.jpg

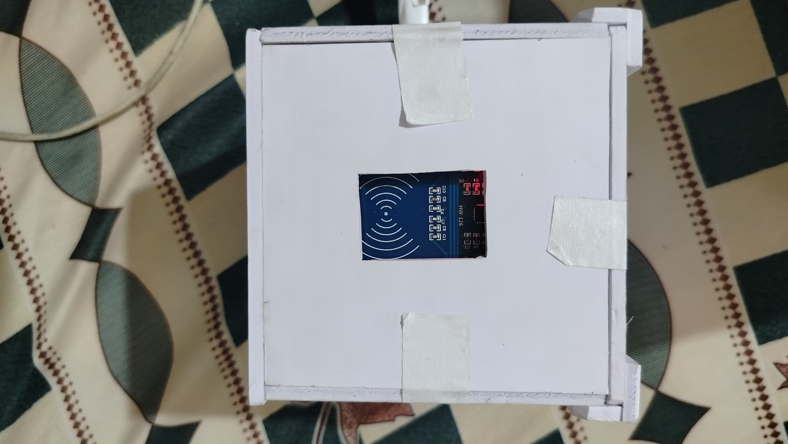
Ảnh datn-20260623T182437Z-3-001/Ảnh datn/IMG20260625043110.jpg
