kzexal/DATN/Ảnh datn-20260623T182437Z-3-001/Ảnh datn/Screenshot_20260622-225418.png

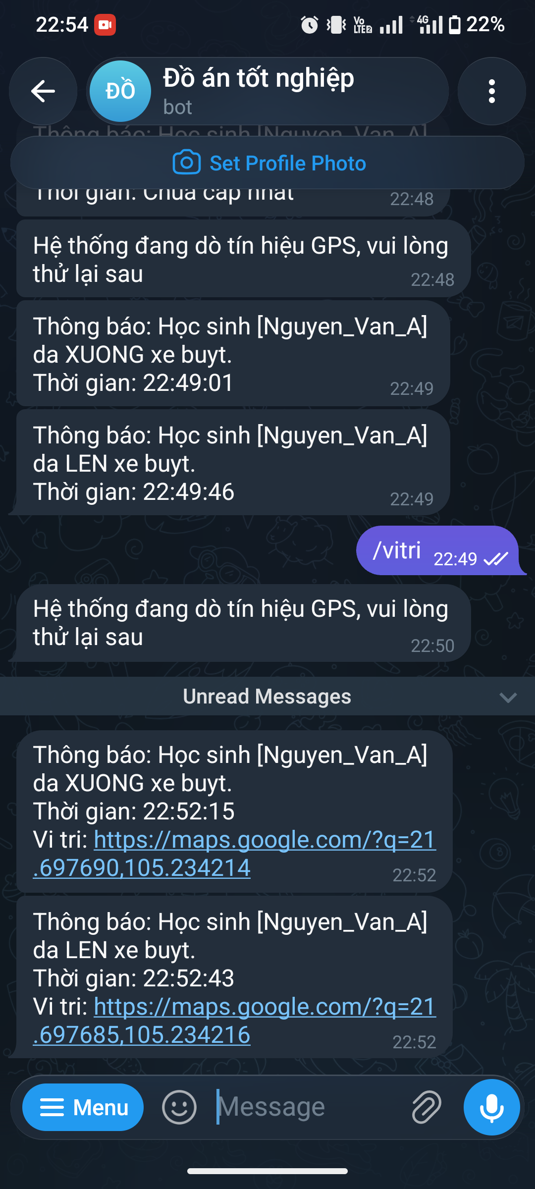
Ảnh datn-20260623T182437Z-3-001/Ảnh datn/Screenshot_20260622-225418.png
