kzexal/DATN/datn_Project/datn_Project.pdf

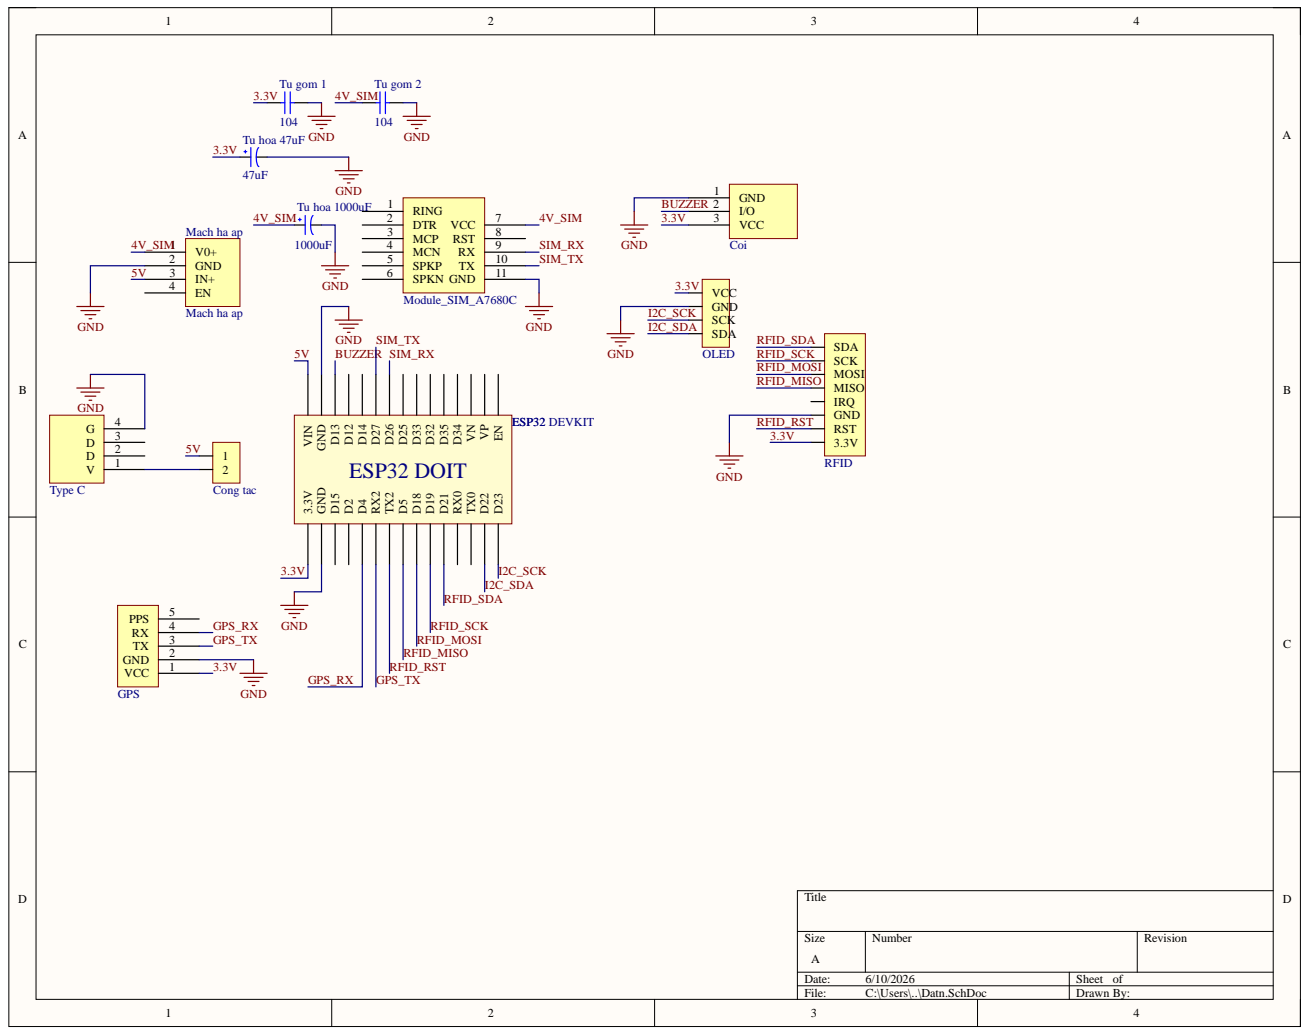
[picture p165: page 1]

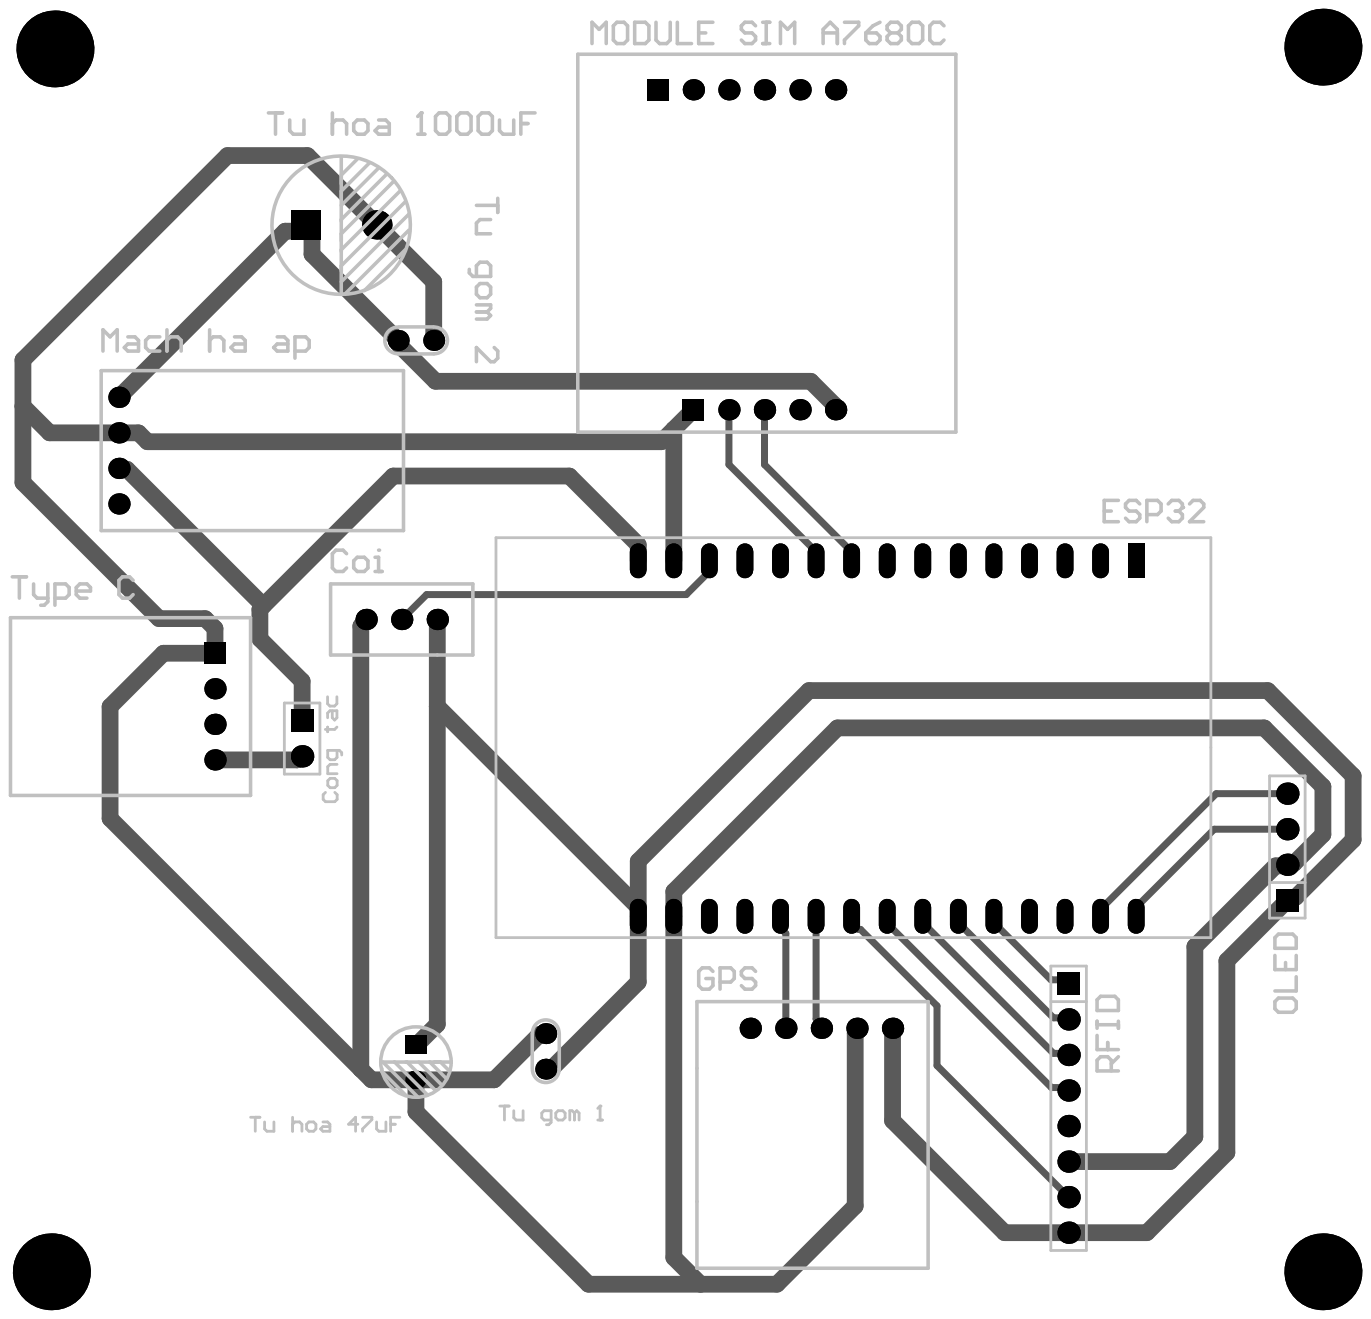
[picture p166: page 2]
