kzexal/DATN/(list of files, drawings)

Other design files:
datn_Project/Coi.PcbLib
datn_Project/Coi.SchLib
datn_Project/Datn.PcbDoc
datn_Project/Datn.SchDoc
datn_Project/datn_Project.PrjPcb
datn_Project/GPS.PcbLib
datn_Project/GPS.SchLib
datn_Project/Mach_ha_ap.PcbLib
datn_Project/Mach_ha_ap.SchLib
datn_Project/Sim.PcbLib
datn_Project/Sim.SchLib
datn_Project/TypeC.PcbLib
datn_Project/TypeC.SchLib
